EXO-AIDER/exo-aider/ADS8688_ADC_ARDUINO/README.md

# ADS8688a
ADS8688a Arduino Library

This code was strongly inspired by 
https://github.com/siteswapjuggler/ADS8688a
