EXO-AIDER/exo-aider/Todo/Hardware ændringer.docx

# Hardware ændringer

- Flyt FSR stik over på filter print (Husk rigtig rækkefølge)
- Fjern notch filter
- Tilføj connection ved modstand I LP filter
- Lav plads til stik (90 grader?). Kun stik i enderne af printet
- Lav plads/find ud af hvor ESPen skal monteres
- Nye filterværdier som set i simulering

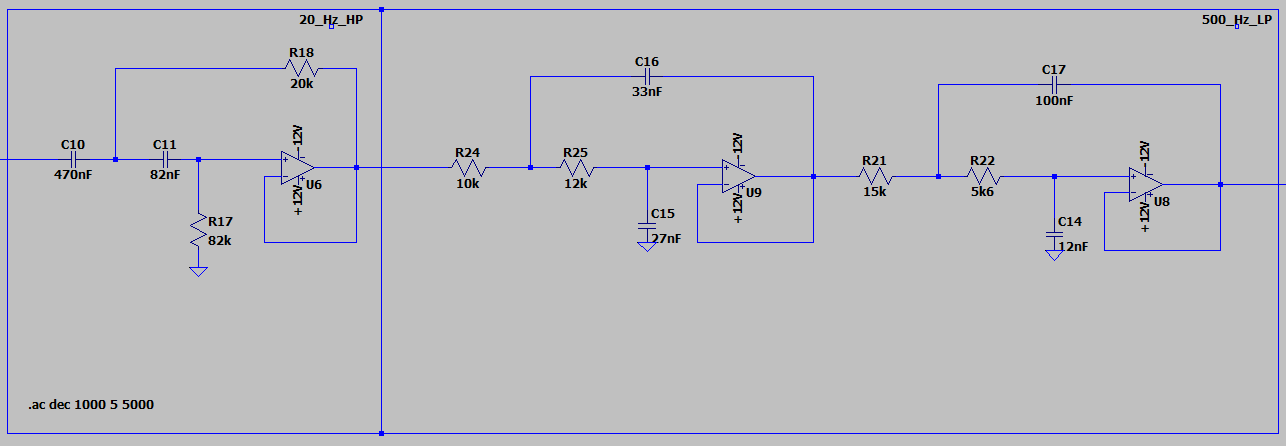
[picture p3: figure]
