EXO-AIDER/exo-aider/PCB/hardware_v2.pdf

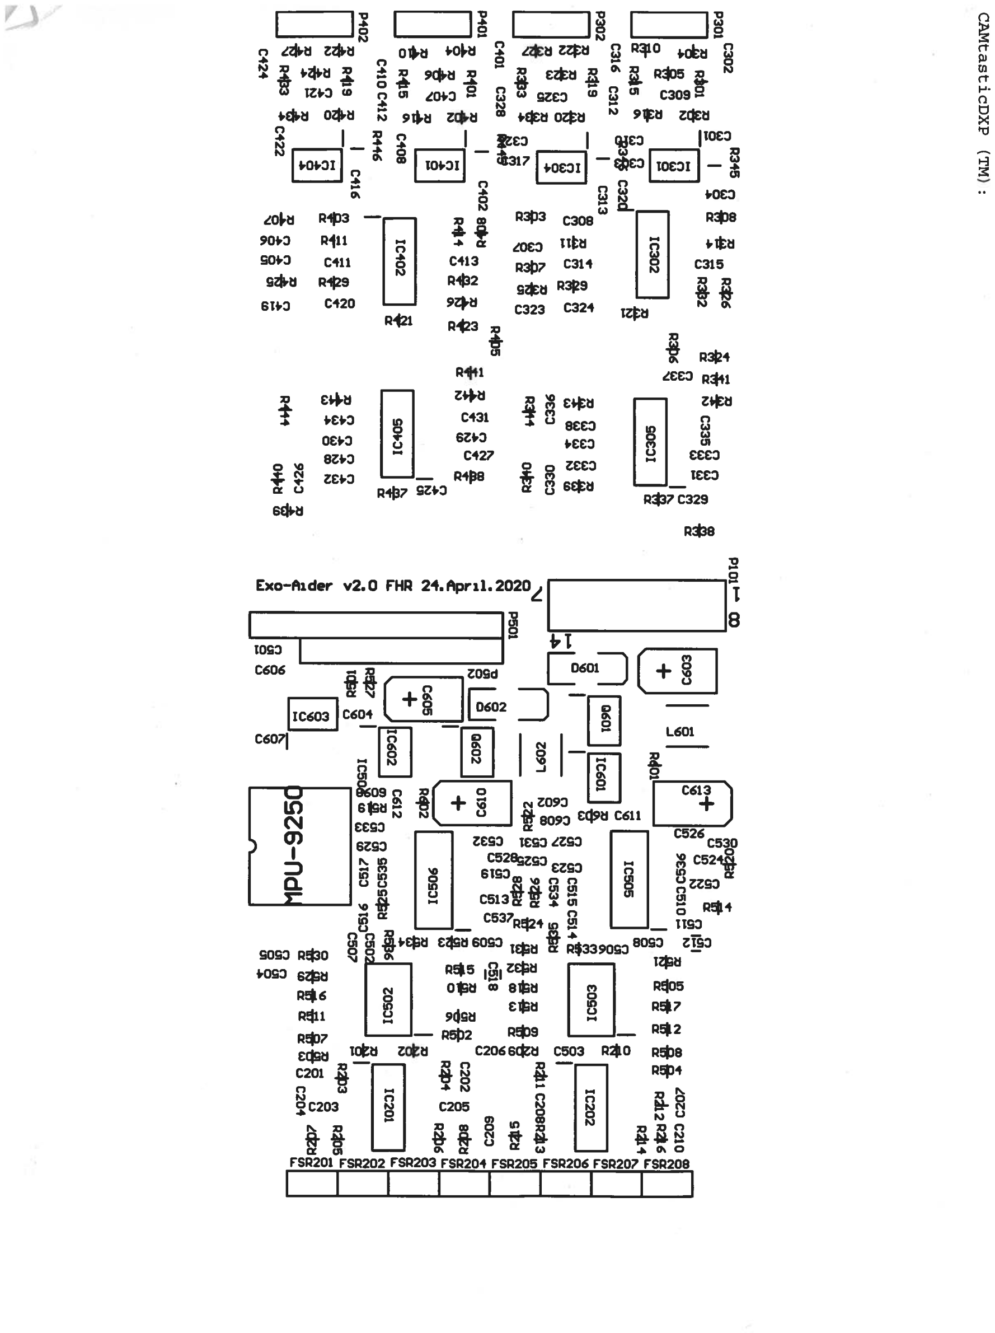
[picture p4: page 1]

### .iapt—ox Q7A tJH4

‘-I

8Ed

P1J39

### 4EttJ SZCO

### C331 P139 8E1*tI

4

D

### n ali-ti C425

t C432

O%C

### I I C333 C332 ° C428

### C33$ C*30 I-iil C429

C434 01 $

### Li *3fl LJ PS2 P142

r

### C337 14tI 1444-ti

## a *4cti to

n

### a c$ti 14? P121 CCCO 4-ZC3 0t*3 P426 C419 C4 ‘0

### 6dCd ftff P1135 6$tI [1 Øti I I aa C405 114-3 i 0 I,D i-ico I I 91C3

I p314 ° P311 I C307 C406 iti-ti mi Li t.
—

# ø P107 cdê-ti

N

1 (‘1 C304

# I 1C404 I I — Iii I304Ieicg IC301c3_ I ____ ____ ____ iN I

### —l caoil C3R3 C32Z I 0

P1134 P1120

### £ P116 P4J2 P3134 P120 Pt6 P3132 (‘4

### øC421 tOt C407 C325cnn 560E3

### P4134 WP436 P$3

N

### P404 P1137 Pl22 P110 P104 P3137 P122

# 0 oifrti

### 51 i oi i St

# Ii i ni nj______ ______

a I al

# a ______ ______

# I I I

# [1 1091 ___

# I Lo

## LIL

14

Bl

# 7otOrttcIwi. I 1.1

9093

C501 I

1’

fltle | EXO-AJDER
Size | Number | Revision
A4 | Blokdiagram | V2.O
Date: | 30-06-2020 | Sheet of I - | 6
LEie: | Z:\Frank\. .\Blokdiagram.SchDoc | Drawn By: Frank Høgh Rasmussen

## DAC_ADCJMU.SchDoc DAC_ADCJMU

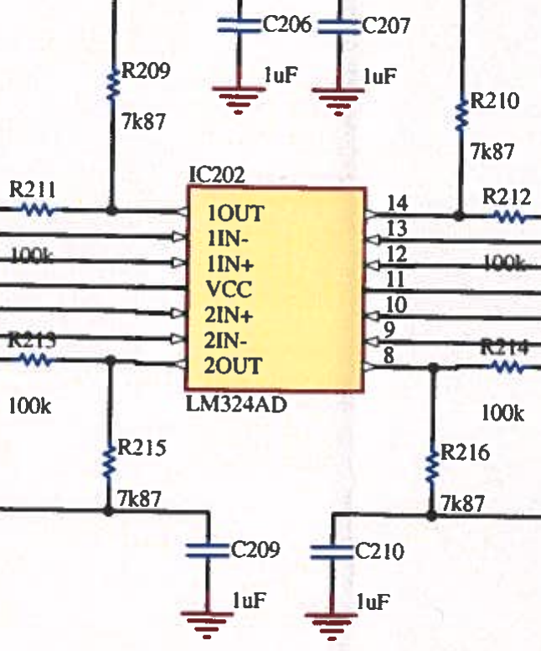
[picture p5: figure]

II,

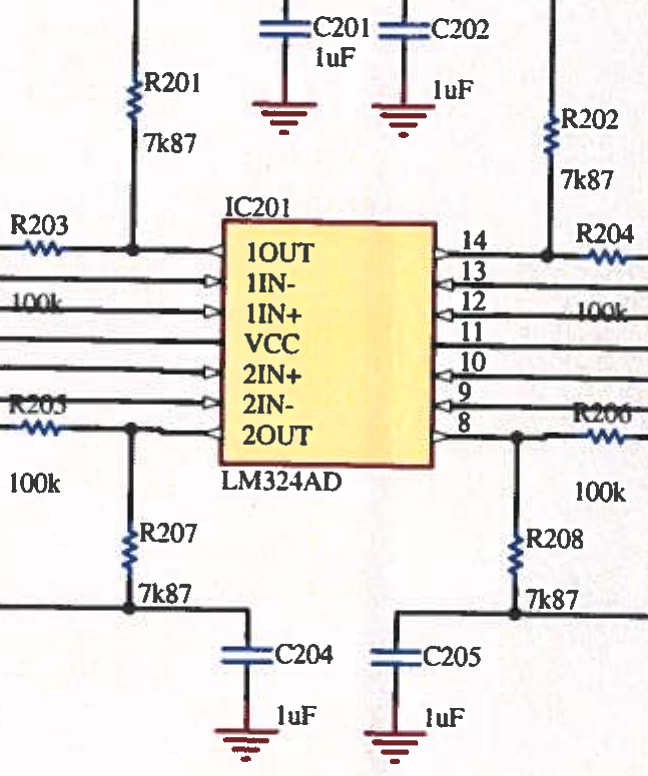
[picture p6: figure]

# SEMG

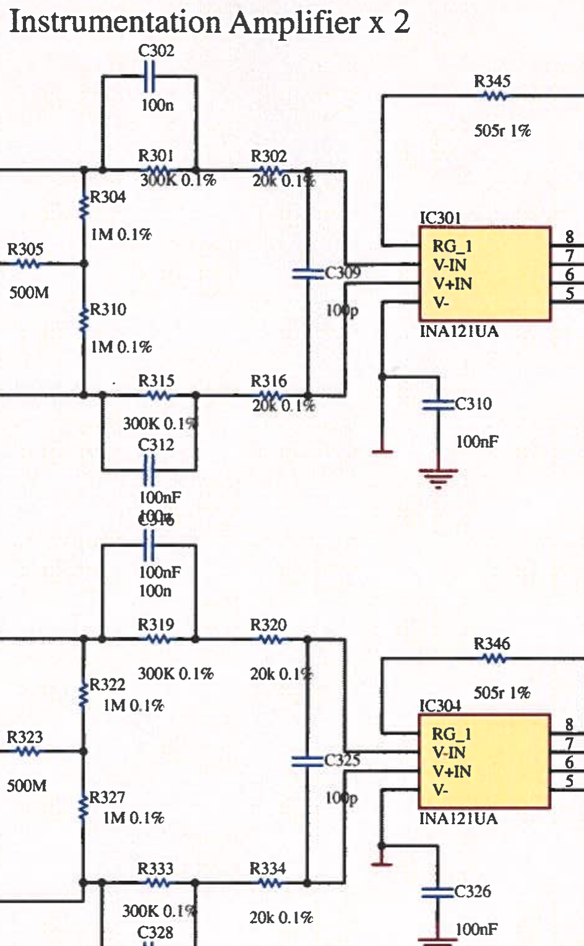
[picture p7: figure]

# High Pass Filter - 20Hz 2.th x 2

20k

C323 | C324
-HI

470nF S2nF
R329
82k

# ADJ-Buffer x 2

# Low Pass filter- 500Hz - 4th. x 2

# Tstle EXO-AJDER

Size | Number | | | Revision
A3 | SEMG 2 | V2.O
Date: | 30-06-2020 | — | Sheet of | 4- 6
File: | Z:\Frank\..\SEMG 2.SchDoc | Drawn By: Frank Høeli Rasmussen

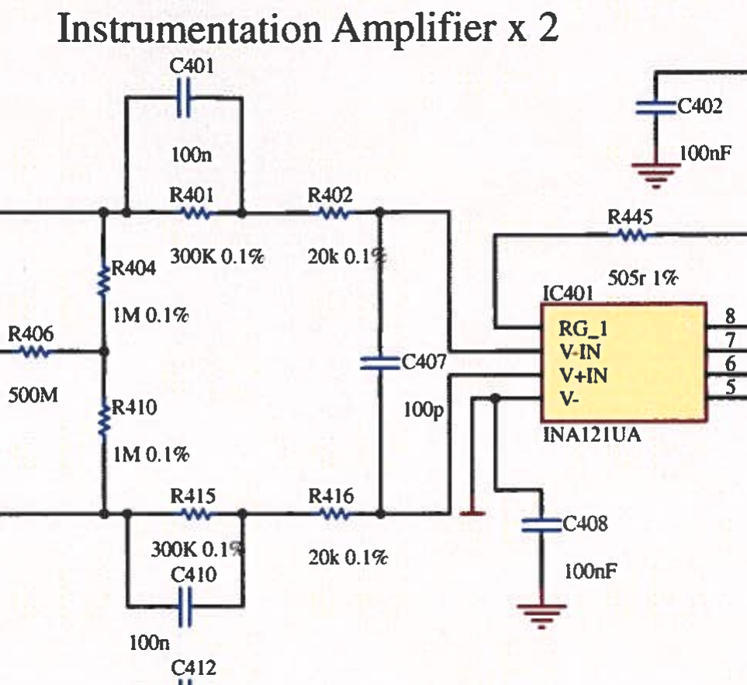
[picture p8: figure]

Instrumentation Amplifier x 2 | High Pass Filter - | 20Hz 2.th x 2 | ADJ-Buffer x 2 | SEMG

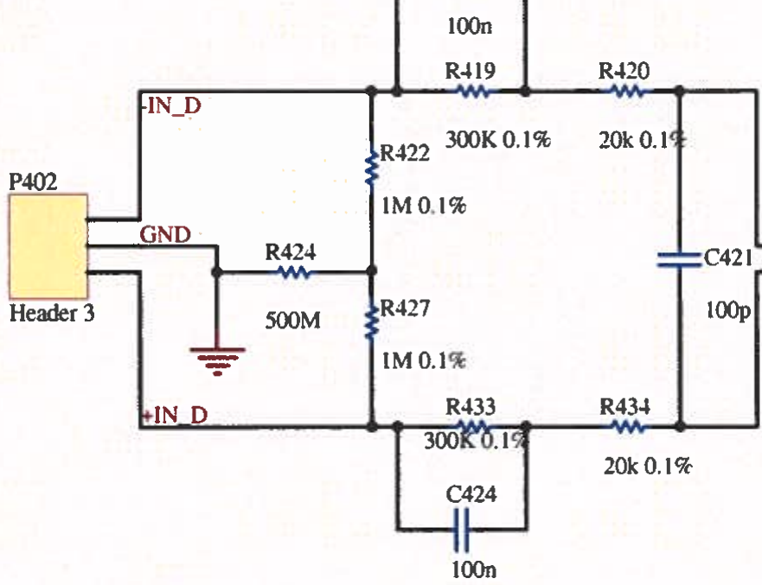
[picture p9: figure]

Low Pass filter- 500Hz - | 4th. x 2
lok | 12k
15k
lOk | 12k

I.

R502

lOK
El

DAC_2

1C503
AGND
FBA
OUTA
OUTB
FBB
REFAB
CL
Cs
DIN
SCLK
MAX525BCAP+

2
3
4
5 OND | 16
FSYNC OND | H
±i
| 8 Header 8

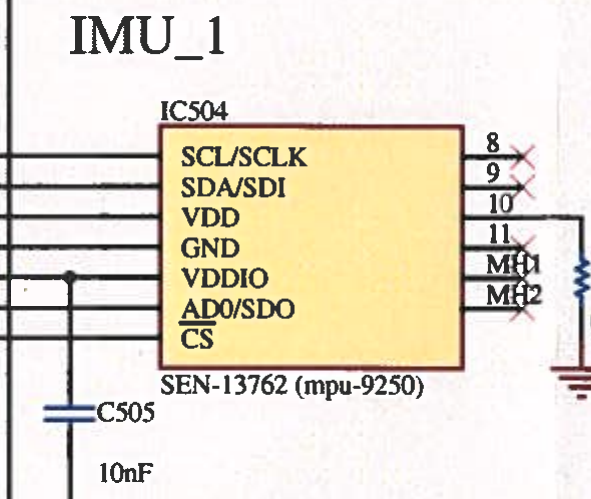
[picture p10: figure]
SCL/SCLK SDA/SDI VDD OND VDDIO ADO/SDO; SEN-I 3762 (rnpu-9250); IMU_1

P501
SDI
SDO
SCK
CSADC

T

CSDAC
CS IMU_2 6 CS IMU I

8
9
-E
- Header 10
L | I | I | I

Tie AGND and DCIND togethee at the DAC, then tie this point to the highest-quality ground available.

## I ——co

C507

DAC_1 | I | 147uF

# _____

LOK
1C502
AOND

R507
FBA | | 5K
OUTA | 17 | - | - | LIN_

MAX525BCAP+

# I+5VD+3v1ELjK

‘C50t

•[.lOOnF

R527

lOK

IMU_2
SDI

R504

lOK

‘C503

‘C5

7u]

1lOOnF I’ R505

- 10K
1J | R509
19
18

_

17

CS DAC

SDI

S(K

16

— | R5l2 | ______ 10K

SDO

1100r

CS_IMU_2

R513

5K

R5 18

lOK

### I+3V3DC 14

13 | I+5v1
11 | I53ji R532 | JR530 10K

SDI

CS ADC | CS ABC
CS IMU I | CS IMU 1 sC8c

19

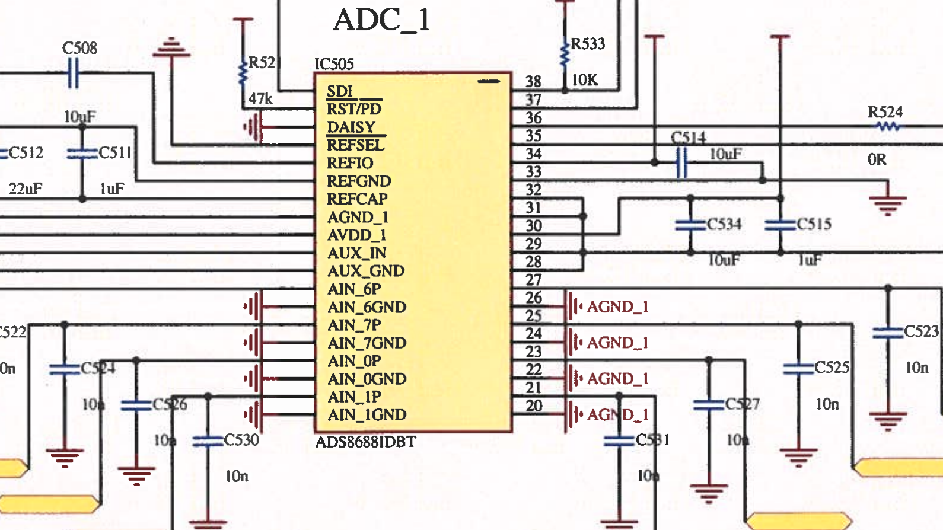
[picture p11: figure]
ADC_1; SDI RST/PD DAISY REFSEL REFIO REFGND REFCAP AGND_1 AVDD_1 AUX_IN AUX_OND AIN_6P AIN_6GND AIN_7P AIN_7GND AIN_OP AIN_OGND AIN_1P AIN_1GND; luF; toul; IOn; II iTtI1_I:
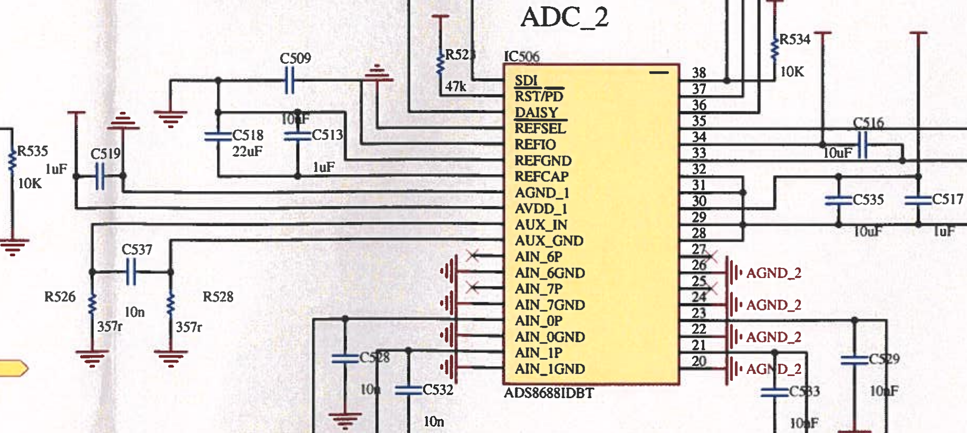
[picture p12: figure]
luF; lOK; ADC_2; j534 _1_J lOK; SDI RST/PD DAISY REFSEL REFIO REFGND REFCAP AGND_1 AVDD_1 AUX_IN AUX_OND AIN_6P AIN_6GND AIN_7P AIN_7OND MN_OP A1N_OGND AIN_1P MN_IOND; OuFII; AOND_2; AGND_2; lOuF; IOn; ]\lJ5O5TtiUb I; _j_ fII.A0_2

C5 10
*

luF

C536
II

SDO

(‘ IMIT ‘)

______________________

### ____________

_______ | ___________

SDI
SDO
SCK
CS_ADC
CS_DAC
CS_IMU_2
CS_IMIJ_I
i-3V3DC
VBAT
OND

____

AGND2 | R55 | OND

R536

lOK

AflND t | R522 | (IND
| Rest Or

1101F!

Res 1
Or | EXO-AIDER
Size | Number
A3 | DAC_ADC_IMU
te: | 30-06-2020 | - | - | - | Revision I Sheet ot
Z:\Frank’i..DAC_ADC_1MU.SchDoc | I Dr | By: Frank hRmussen

i

0

(i)

<

4: —

+0
rJ+

III,

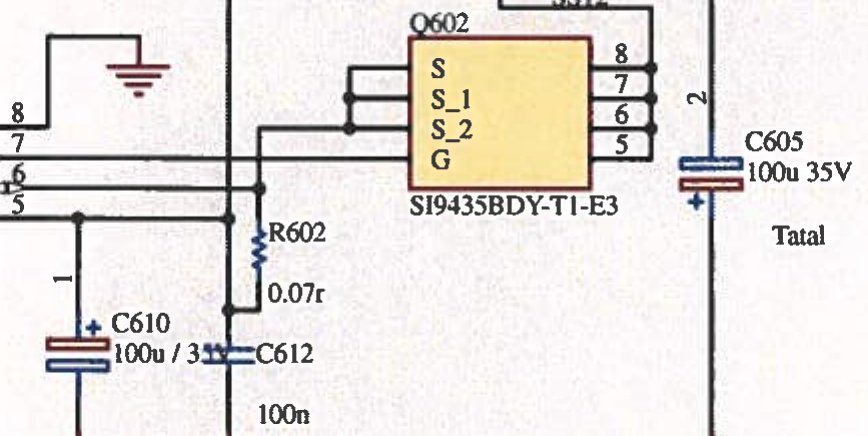
[picture p13: figure]
