EXO-AIDER/exo-aider/Pictures/hardware_block_diagram.pdf

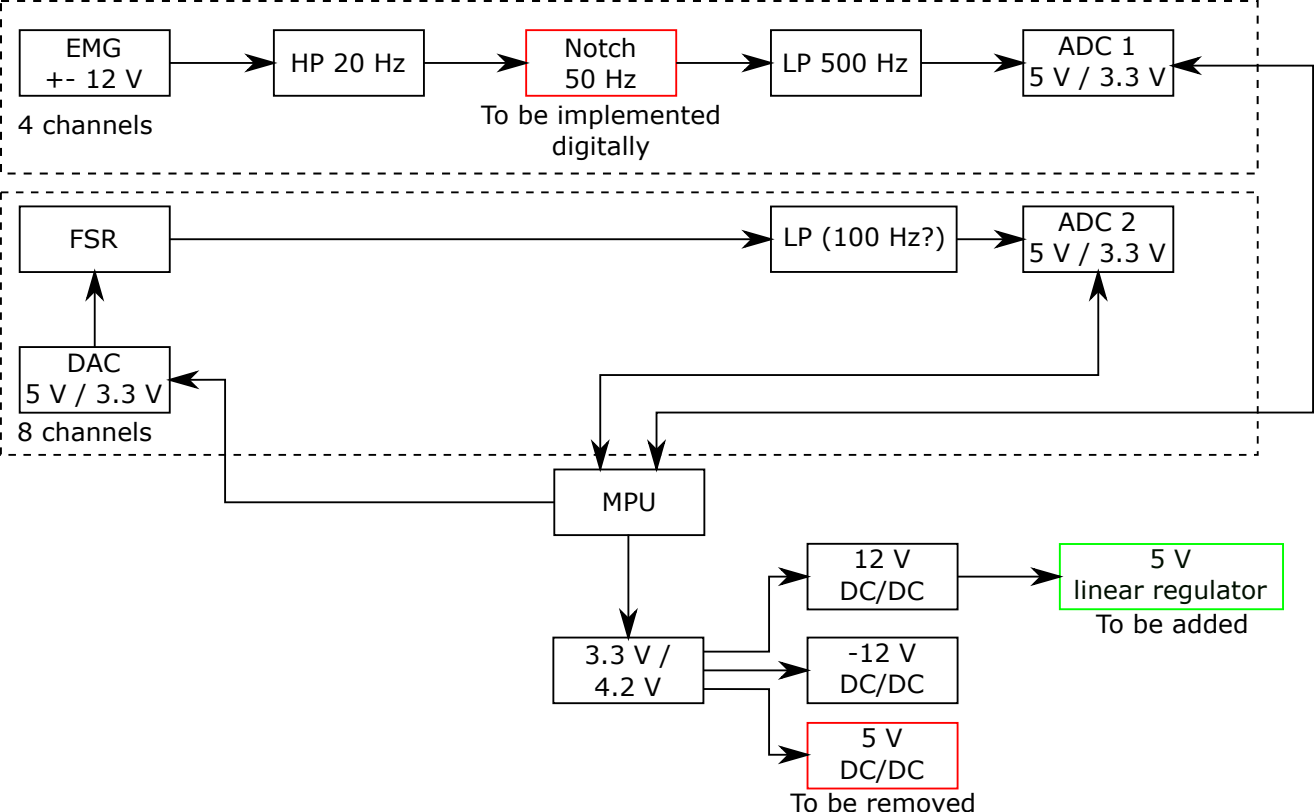
[picture p14: figure]
MPU; ADC 1; Notch; 50 Hz HP 20 Hz EMG +- 12 V; FSR; DAC 5 V / 3.3 V; ADC 2 5 V / 3.3 V; 4 channels; 8 channels; 5 V linear regulator; To be added; To be removed; To be implemented digitally
