EXO-AIDER/exo-aider/Pictures/matlab_block_diagram.pdf

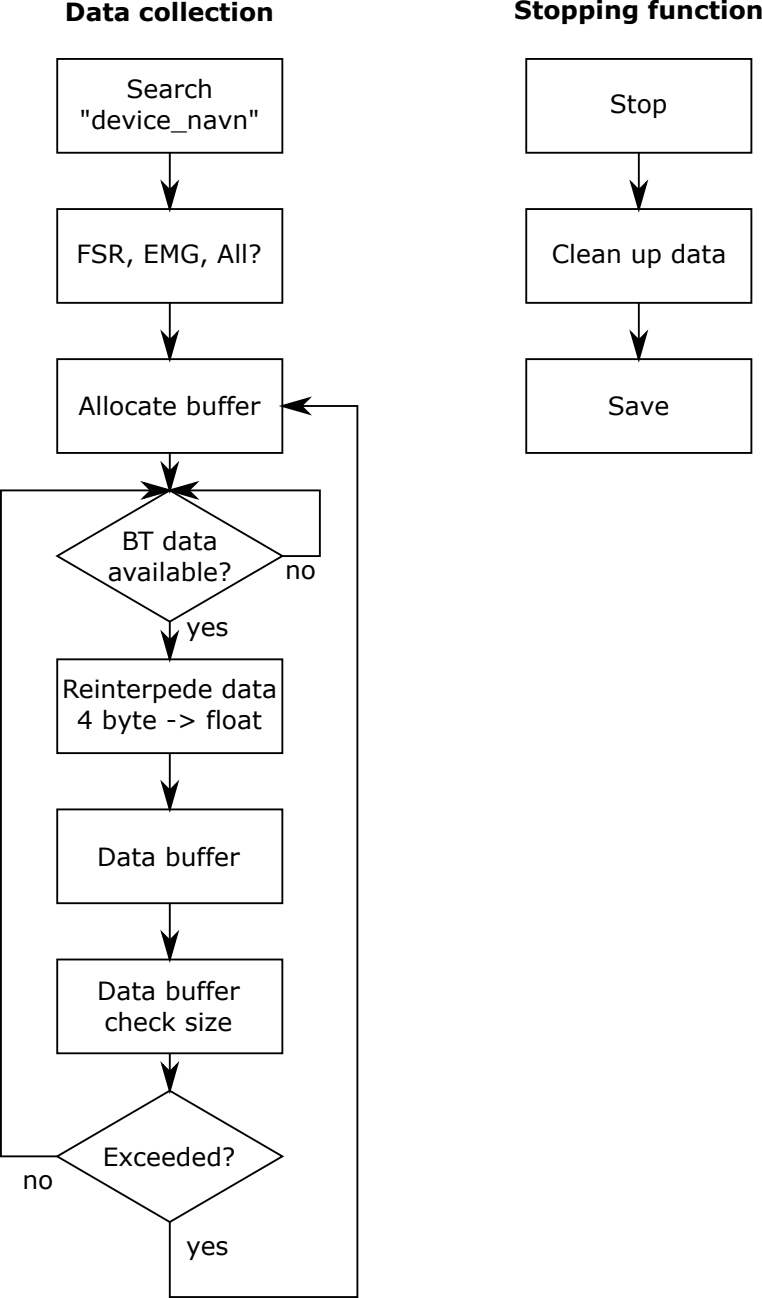
[picture p17: figure]
Reinterpede data 4 byte -> float; Search "device_navn"; Data buffer check size; FSR, EMG, All?; Allocate buffer; Data buffer; BT data available?; Exceeded?; yes; Stop; Clean up data; Save; Data collection; Stopping function
