EXO-AIDER/exo-aider/PCB/Scaned documentation/HW Version Zero.pdf

1 2 3 I 4

## SEMG_1 SEMG_I .SchI)oc

## SEMG SEMG2

## 2.SchI)oe

## DAC_ADC_IMU

## DACADC_IMU.SchDoc

## GND OND

## SEMGC <_

# SEMG_D (

## FSR.Sc

FSR

Doc

D
c
B

A

r

## FSR2JN

## FSR1J

K-Z

# FSR3jN (

## FSR4 IN

# FSR5_IN <-

## FSR7_IN

## FSR6JN

C

# FSR8_IN K_

# FSRLOUT <

## FSR3.OUT FSR2_OUT

<‘

## FSR4OUT <‘

# FSR5OUT <

# FSR6_OUT (

FSR7OUT <,

# FSR8_OUT <

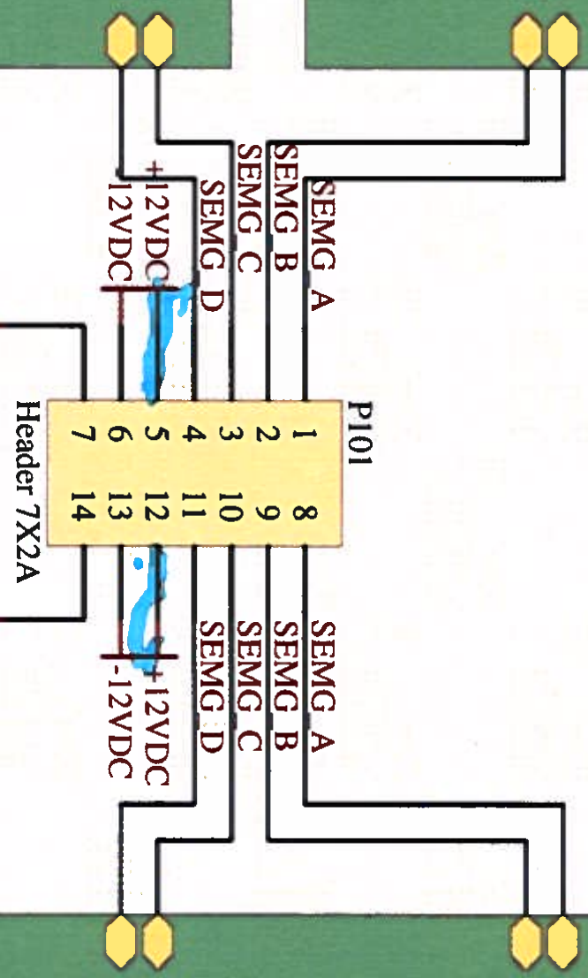
[picture p18: figure]
MGA; EMG B SEMO B; SEMG c 2 SEMG_C SEMG D 3 10 SEMG D

## •> SEMG_C

## > SEMG_1)

i’

## FSRI EN

## — FSR2 IN

## [SR3 EN FSR6JN

## FSR5_IN

## FSR4_IN

## - — FSR7_IN

•

FSR

## FSR8_IN

## t _OUT

## ISR4J)UT

## FSR3_OL

## [SR2_()UT

)

## FSR6_()UT FSR5J)UT

- ;

## [:SR8OUT

## FSR7_OUT

## U POWER

## ‘Doc

I

A

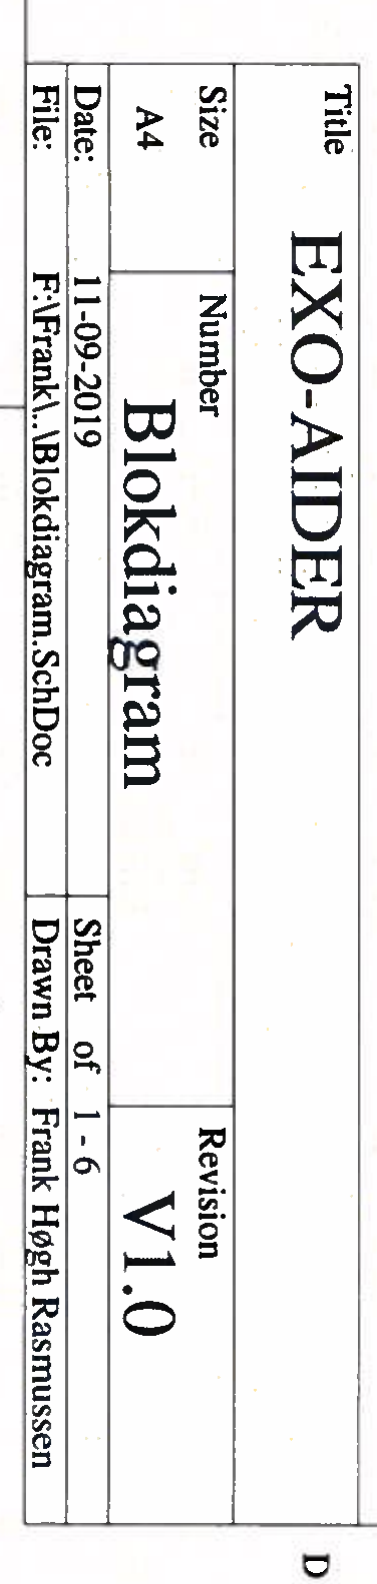
[picture p19: figure]
EXO-AIDER; Size Number Revision A4 Blokdiagram Vi .0; Date; 11-09-2019 Sheet of I - 6

## File: F:\Frank\. .\Blokdiagram.SchDoc Drawn By; Frank HØgh Rasmussen

2 I 3 4

# I I 2 3 I 4 5 6 7 I 8

2 3 4 5 6 7 /

i-i:

GND

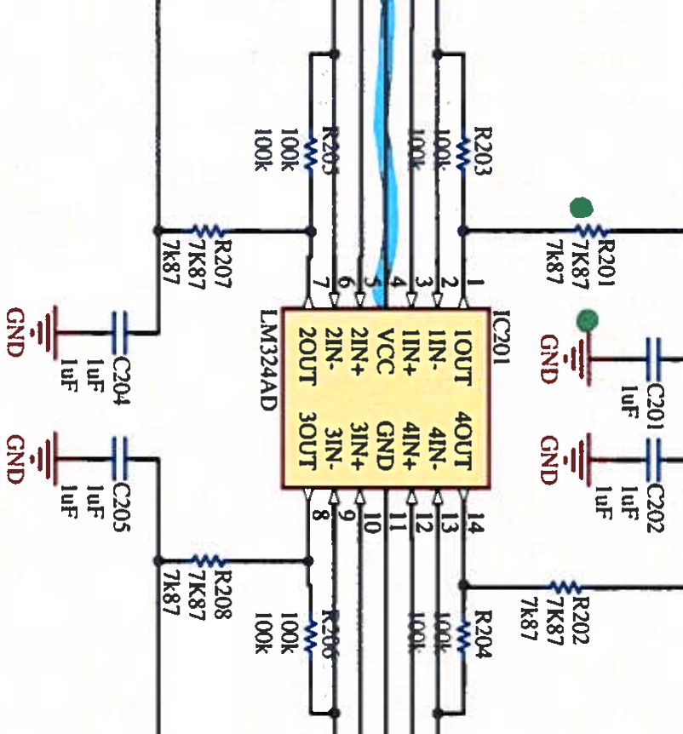
[picture p20: figure]
GND GND

GND

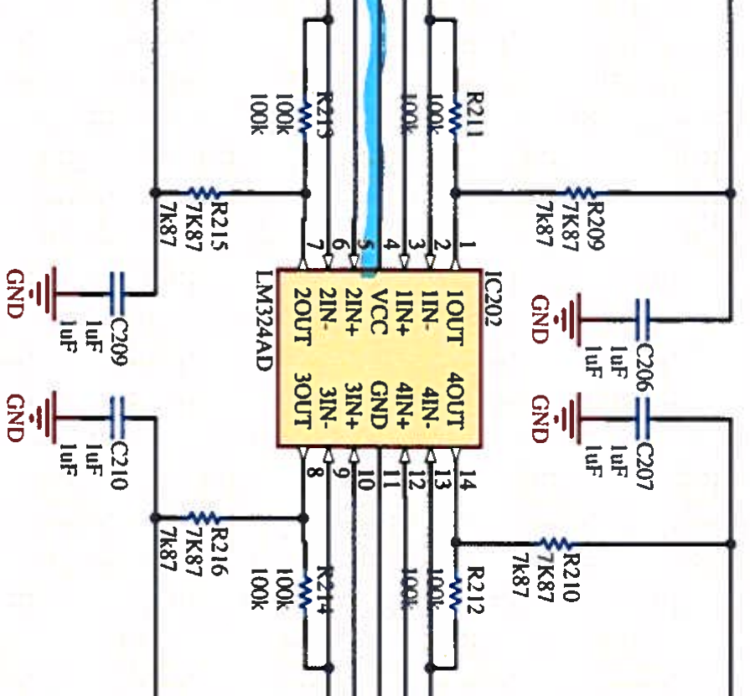
[picture p21: figure]
I j0 II uF luF luF; GND GND

l-SICStJS

# rtLJ

_[

Header2 -

GND

GM)

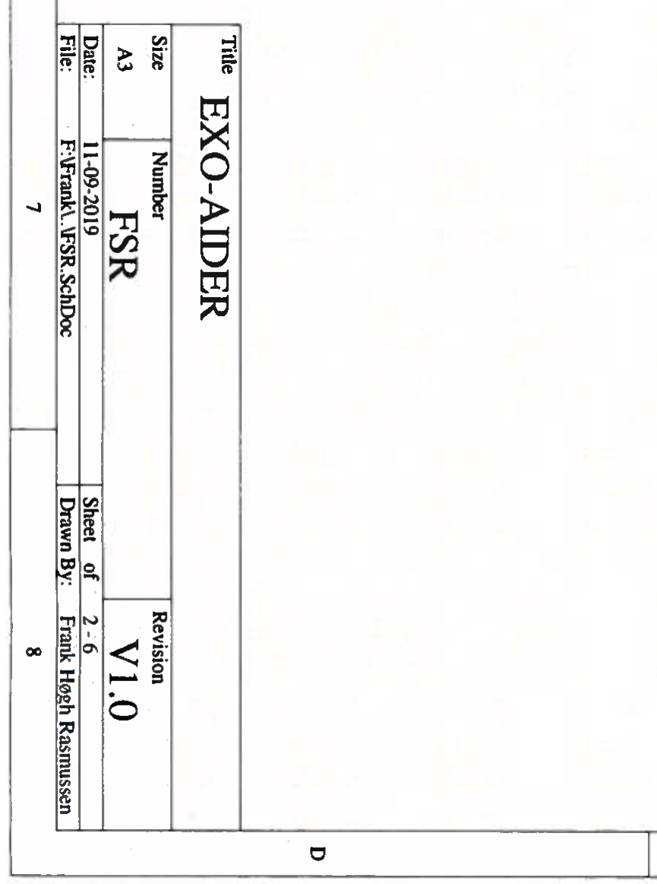
[picture p22: figure]
flue EXO-MDER; Size Number Revision A3 FSR V1.O; Date: 11-09-2019 Sheet of 2-6

File: F:FrankV.\FSR.SchDoc Drawn 8v: Fiank Hoeh Rasmussen

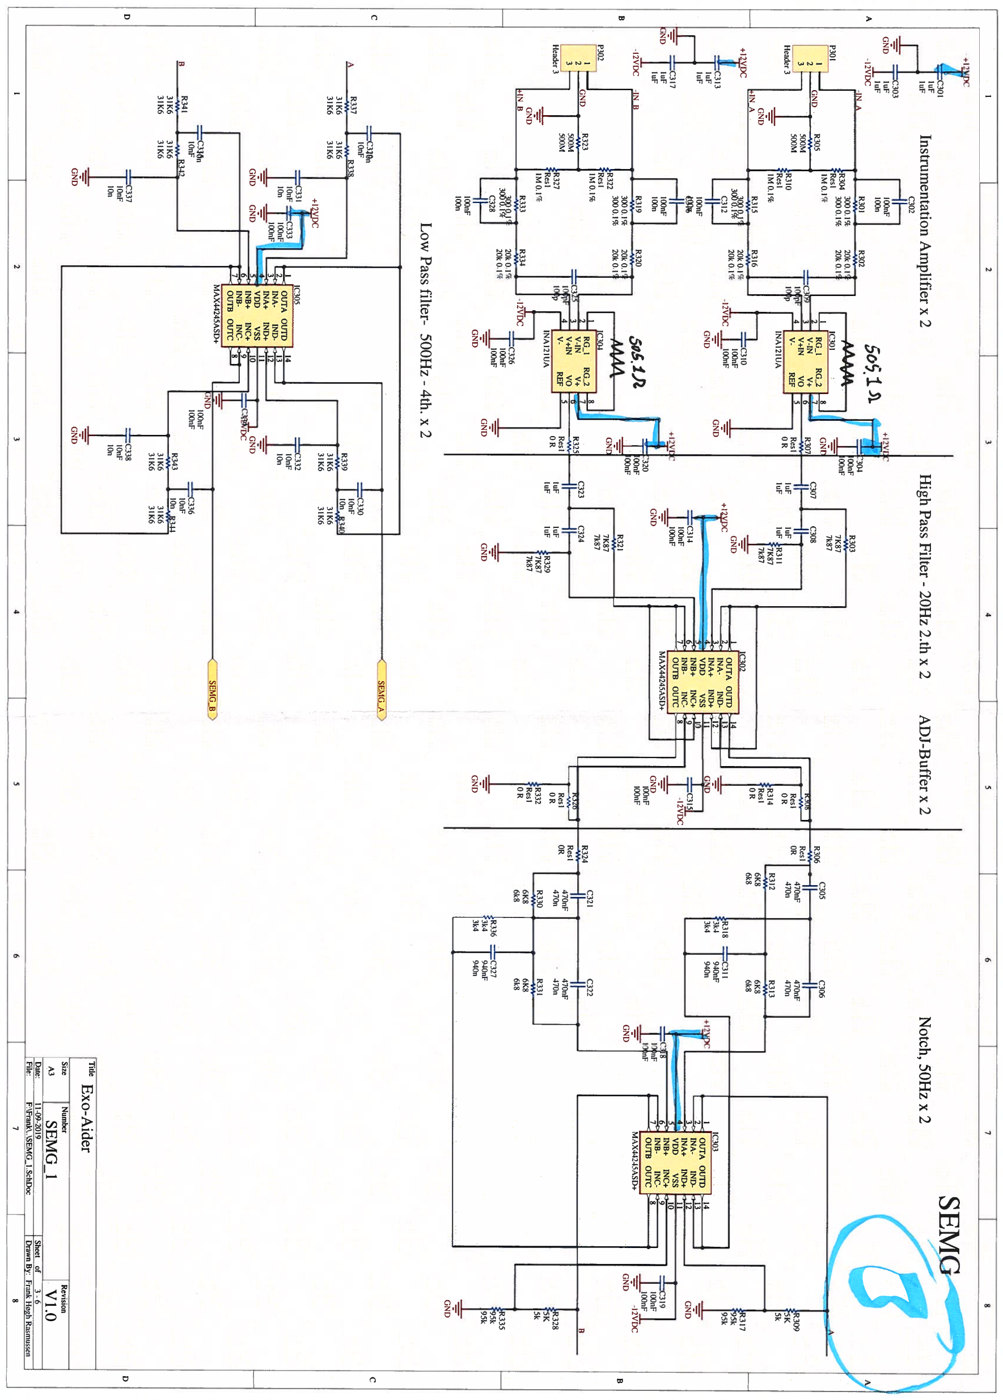
[picture p23: page 3]

I

+I2VDC

GN[3

c.o3

luF

luF

-I2VDC’

P30!
2 —3,

Hzader 3

## Instrumentation

C302

Res

R3I0

I

# IM 0.1% - R315 - R316

300 0. IÇ 3000.1%

C3 12

# Hft

IOOnF

# Hft

3000.1%
3000.1%

R319
lOOn

IOOisF

R327

Res I
IM 0.1%

R333 R334

## Low Pass filter- 500Hz - 4th. x 2

## ADJ-Buffer x 2

OR
Resi

R3 14

Res I

OR

## C305 C306 R306

## I 470nF OR

470n
C32t C322

ResI
R324

I II

470n

OR

R330

470nF

±C327

940nF

Jz

## Exo-Aider

Size Number Revision

# SEMG_1 I V1.0

Date: 11-09-2019 Sheel of 3-6

File: F5Frank\..\SEMG_1.SchDoc Drawn By: Frank Hoh Rasmussen

2 I 3 4 L 5

3000.1% R304 3000.1%
IM

Resi

0.1%

R305

20k 0.1

2OIs 0.1’

500M

500M

GND

I

fIN A

6

10

l0

I 7 8

## Notch, 50Hz x 2

L313

+12\’DC
I

I uF

I uF

=- C317
IND

luF

luF - 12V DC

Fleader

P302]

20k 0.1%

20k 0.1%

R320

## Amplifier x 2

+12V]

R302

i 51.

# I ic I

IPFN_RG2J_GM

INAI2ILA

OR

# —r 00sF

-I2VDC JJ00nF

GÇD —+ 12 VI

## 5g7LJZ

.14

1C30-4

GM

RcL2J

:

INAI2IUA

OR

-12 V DC

—‘—C326

I00isF

IO0nF

GND

-IN B

# SEMG 1

20k 0. I

20k 0. I

Res

R322

I

IM 0.1%

## High Pass Filter - 20Hz 2.th x 2

OOnF
304

R303
w.

7k87

OOnF

j

7K87

C307 C308

# II i i ItiF luF

7K87

# luF IuF3II I

7k87

## __________ — IC302

GND

# OUTA OUTD L14 I +I”VDC 2 INA- IND- L13 I

# ___

# 12 I i÷ IND+ III GD VDD VSS I 10

## 1-C314 INB÷ INC÷

## IOOnF i- INC

# J_IOOnF OUTB OUTC PH \IAX44245ASD+ GND

0OnF

0OnF
320

R32I

I

7k87

7K87

C323 C324

# -HI I luF 1sF

7k87

7K87

luF aF

G\D

R323

R3

470n

470nF

13

6kS

6K8

500M
500M

GND

I

-I5 R

6k8
6K8

C3

10
10

3k4

3k-I

R318 zC31 I

940n
940nF

±C3I5j

-I2VDC

GND
IOOnF

IOOnF

20k 0. 1%

20k 0.1%

3000.1

300 0. 1%

lOOn

IOOnF

C328

4
3:

5k

5K
R309

Ic

R3 17 _________________________________ 95k 95k
OUTA OUTD

INA- IND

## INA+ IND-i- i7

VDD VSS

# __t_C319 I

# INB- INC- 8 [I00nF I OUTB OUTC J_IOOnFj

MAX44245ASD+ -I2VDC

GN D GND

# I nF 7 nF

Res

“to

I

GND

3! K6
3! K6

R331
470n

470nF

6k8

6K8

31 K6

3IK6

6k8

6K8

B

3k4
3k4

R336

31 K6

31 K6

95k

95k

R335
5k
5K

R328

GND

31 K6

31 K6

31 K6

31 K6

1 2 3 4 I 5 6 7 8

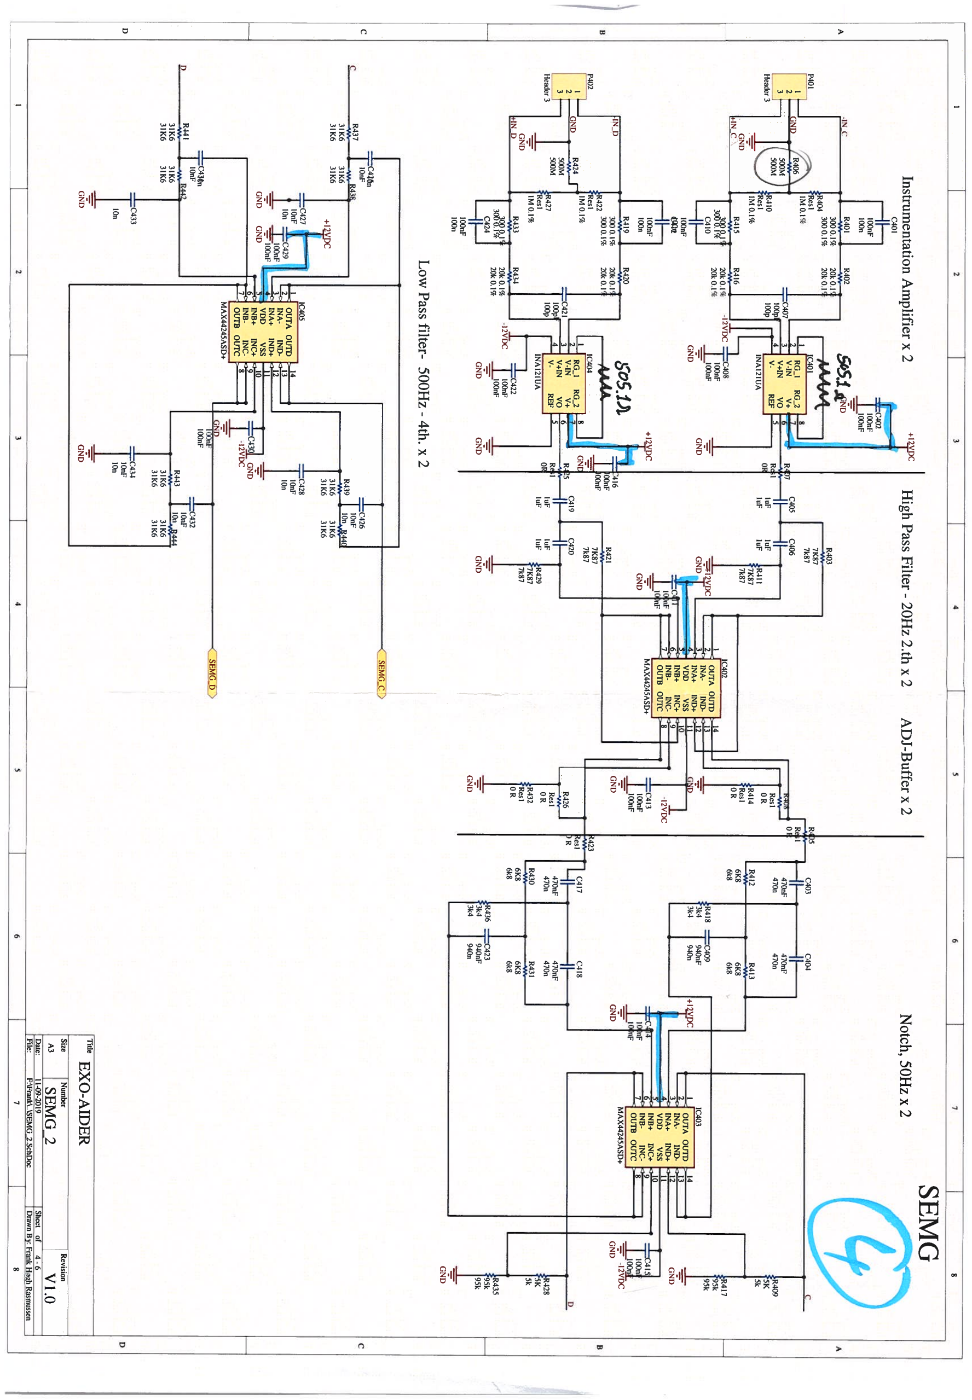
[picture p24: page 4]

I

## [is_i 3000.1%

P402 I

J.R4» 3000.1%

I --

I

ResI

2

IM 0.1%

500M R1

OND

IM 0,1%

## R433 IN D

lC403

_______

10

# OUTC I

MAX44245ASD÷ — -12’

GND

## i I 2 I 3

IN C

# Instrumentation Amplifier x 2

0l

, .

-C402

lOOnF lOOnF

lOOn lOOnF

# R401 R402 5c5j ND

L

Header

P401

3

# ..—.———w——-..—-—--——-w—.— I — 3000.1% 20k0.1{

R404 3000.1% 20k0.11

Res I

“

‘

IMO.I%

OND

500M

R406

]

500M

I3.i%

# 4N_C - R4I5 — 300 0.1 20k 0.1%

R4l9
lOOn

;i
lOOnF

R-I20

1C401
RG1 RG_2

C407

‘

R

INAI2IIJA

-I2VDC

iOOnF

lOOnF

C408

GND

GNO

8 6

# SEMG

# Notch,5OHzx2 IIIIIIFI%IIII%)

470n
470nF
C404

R413

# High Pass Filter -20Hz 2.th x 2 ADJ-Buffer x 2

R403

I

# 7K87 R 7k87

# II T ResI I OR luF luF R411

c405 C406

# 7K87 I R4l4

ResI

luF luF

}87

## OLTA 14

1C402

# I2V1)C INA- IND T IND+ I12 I

# I11 GND i— I ‘ VDD T i Q INII+ INC÷ — I 6 INB- INC i( nF OUTB O1JTC 8 — I -I2VDC

MAX44245ASD+ ‘C4l3

### OND TIOOnF

......LIOOnF

416 G\D

7k87
R421

I

7K87

C4I9 C420

# HI II

nF luF

7K87

R4’9 luF luF

GND

}87

6k8

6K8

20k 0.1

20k 0. I

R434

# C403 E}HH

470n

470nF

R$ 12

423

R4 18

3k4

3k4

+I2VDC

__
t1: 1C404

### V-IN + R

# L_JJ RG 2 8

## C421 _I v+IN VO

______

### R —j_ V- REF

# 1\A 121 CA :1- ±c4 Ol I\DC

# II00nF IOOnF

OND OND

=C409

940n

940nF

+12VDC Ï

lOOn

IOOnF

C424

6k8

6K8

# ‘j 9 C417 RHH

470n

470nF

R430

R4
5k
5K
R409

17

95k
95k

“DC

20k
20k0.1%
0. 1%

# Low Pass filter- 500Hz -4th. x 2

Res

R426

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
R436

zC423

940n

940nF

31 K6

31K6

95k

95k
R435
5k

5K

R428

GÇD

31K6 311(6

# EXO-ALDER

Size Number Revision

# A3 SEMG_2 Vi .0

Dale: 11-09-2019 Sheet of 4 - 6

File: F:Frank\..’SEMG_2.SchDoc . Drawn By: Frank Hogh Rasmussen

2 4 5 6 7 8

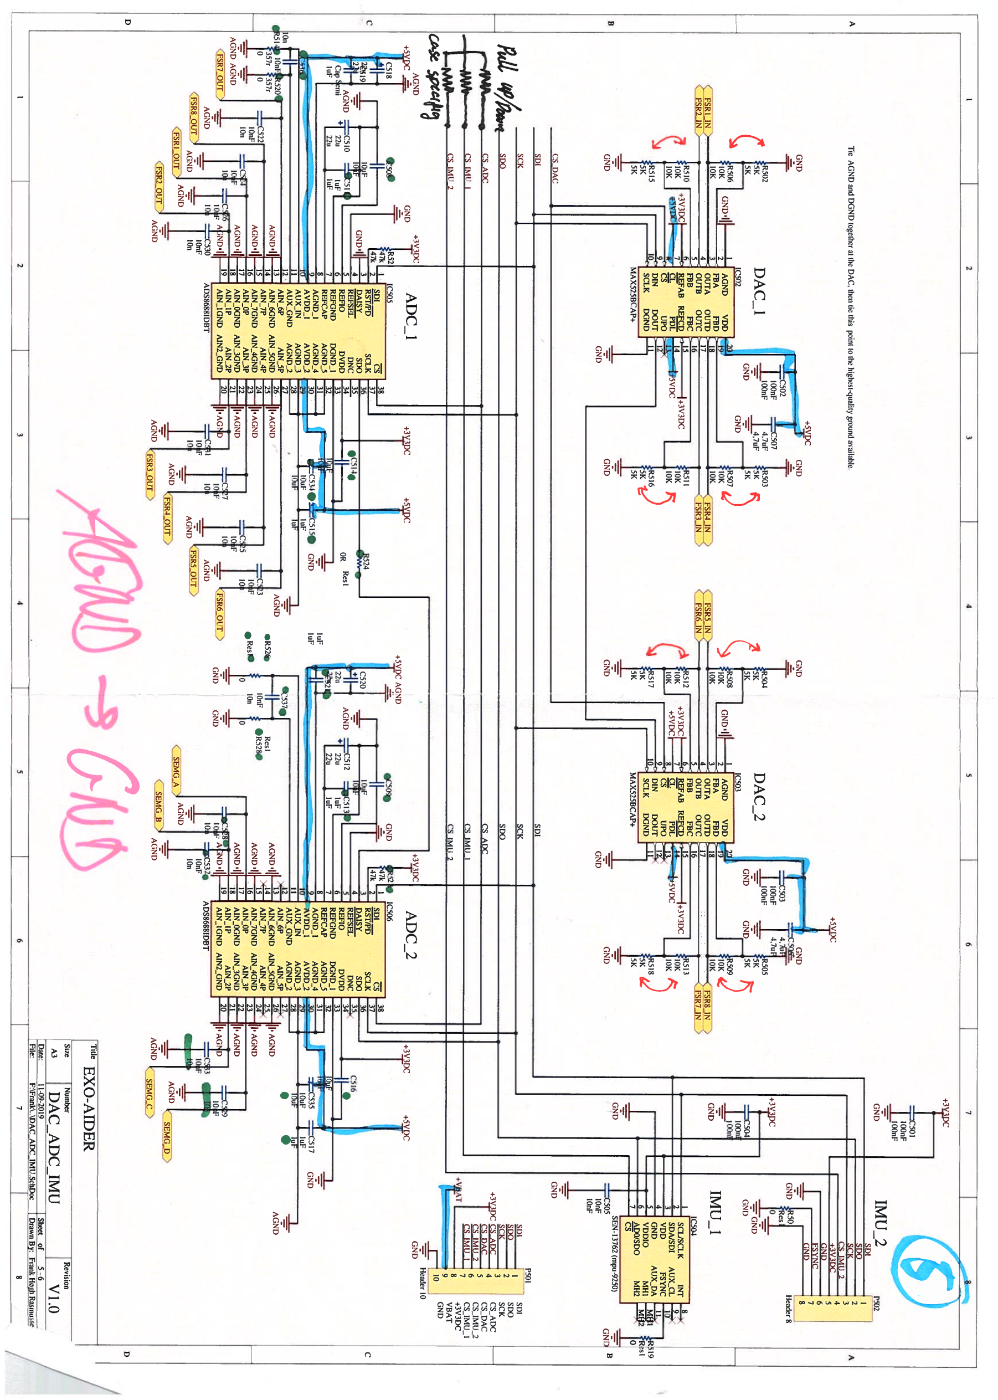
[picture p25: page 5]

### I I 2 3 I 4 I 5 6 7

+5VDC

IOOnF C507

### DAC_1

IOOnF

G\D

GND

19

20

$÷3v3Dc

### I+5VDC

GND

i

### ADC_1

1C505

cs

SCLK
DNC
SDO

AIN_IGND
AIN_IP

AIN_OGND
AIN_0P

AIN_7GND

AIN_7P

AIN_6GND
AIN_6P

AUX_GND
AUXJN
AVDD_1

AGND_1

REFCAP

REFGND

REFIO

REFSEL
DAISY

RST/PD
SDI

ADSS688IDBT

lOK

R507

5K
5K
R503

FSR3JN

R51 I

5K

5K
R516
10K

lOK

G\D

1(503

### DAC_2

AGND VDD

FBA FBD
OUTA OUTD

OUTB OUTC

FBB FBC

REFAB REFCD

PDL

Cs Upo
DIN DOUT

SCLK DGND

NIAX525BCAP+ 5K

5K
R518
lOK

lOK

R513

GND

+3V3DC
I‘C50l lOOnF IOOnF
GND

I

+3V3DC

IOOi

lOOn

GD

IOnF
lOuF

C505

P501

SDI

## 2 SCK

+3V3DC CS ADC
T

(‘S

(‘SDAC
IMt 2

C’SIMtl

Header tO

G\D

Tie AGND aird DGND together at the DAC. then tie Ihis point to the highest-quality ground availahie.
T502
GND

# O6 GND ‘ii

lOK

GND

1(502
SCLK
DIN

CS
CL

REFAB

FBB
OIJTB

OUTA
FBA

AGND

FBD

VDD

OUTC

OUTD
FBC

REFCD

Upo
PDL

DGND
DOUT

GND

lOK

lOK

5K

5K

hIAX525BCAP+

G5D — CS_DAC

## I ..-.___.-___

+5V DC

(‘503 4,7ii
IOOnF d,7u
lOOnF

5K

R505

GND GD 5K

r

lOK

# R509 -—8JN

CS
srtn

SCK

ADC

EB

## R.512 +3v3DC1

lOK

VDC8

R5l7

5K
5K

GNO

CÇ I\{Tr

# IMU_2 ri P502

CSIMU2

GD R501 Header8
fi

UND

UND

### IMU_1

1(504

# i1j S/SDI AUXCL

OND AUX_DA

MH2

SEN-t3762 (mpu-9250t

ONE

# I+3”3 :4*svDc

i-GND

C’S l\11 2

C

GAD

I

### Ct’ÇL

AGND +3V3DC

÷5VDC GND
•50 R52 C5 18

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
+3V3DC +5VDC
I

GAD

C T?sÆtT i

CS IMU 2

+5)C AGND

# C514• --—-— i OK ResI

L11T.
32

(

DVDD

AGND_2
AGND_3

AVDD_2

AGND_4

AGND_5

DGND_I
AIN_SP

AIN_5GND
AIN_4P

AIN_4GND
AIN_3P

AIN_3GND
AIN_2P

AIN2_GND

## FSR2_OUT AGND

# ADC_2

### cso GND 52 1C506

747k i

L512

I.

# IF—147kT

AGND

T22u

luP

22u luF 7

22u
C520

I uF
luF

+3
CSJMU_1

CS_IMU_2

CS_DAC

CS_ADC
SCK
SDO

SDI
V3 DC

GND

VBAT

8

•R524

.Res

+3V3DC +5VDC

36

37

C516

3’ I

__

AG.ND

# ____

# ! 4__ t 7 FSR6

FSR5 0111’>

## AGNO 4 OUT

AGND

•C537

ResI

### tOnF •R528•

tOn

O 0

GND UND

SDI (5

RST/PD SCLK

DAISY SDO

REFSEL DNC

REFIO DVDD
REFGND DGND_1

REFCAP AGND_5
AGND_1 AGND_4

AVDD_1 AVDD_2
AUX_IN AGND_3

AUX_GND AGND_2

AIN_6P AIN_5P

AIN_6GND AIN_5GND

AIN_7P AIN_4P

AIN_7GND AIN_4GND

AIN_OP AIN_3P
AIN_OGND AIN_3GND

AIN_IP AIN_2P
AIN_IGND AIN2_GND

32 Ii) II-

31 I 1#

## 30 .i-.-1.I C535 — C5l7

## 29 1 I lOuF T’luF

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
AGND

AGND

ii

AGND II

AGND

# AG\D __ K

ADS85881D13 I

## -i- tUut- lut- 28 I

# AG’D t’ I1G

JIAGND
Ii.

—‘—C 9

### --llI.AG}

AG\D

ACD

SEMG_>

2 I 3 I 4 5 6

I File:

# Title EXO-MDER

Size Number Revision

# A3 DAC_ADC_IMU V1.O

## Date: 11-09-2019 I Sheet of 5 - 6

# P-sP,,,L-\ sriuc urir’ mAlt e.hrs,, Frank Hugh Rasmuss / Drawn By: I 7 I

+ {

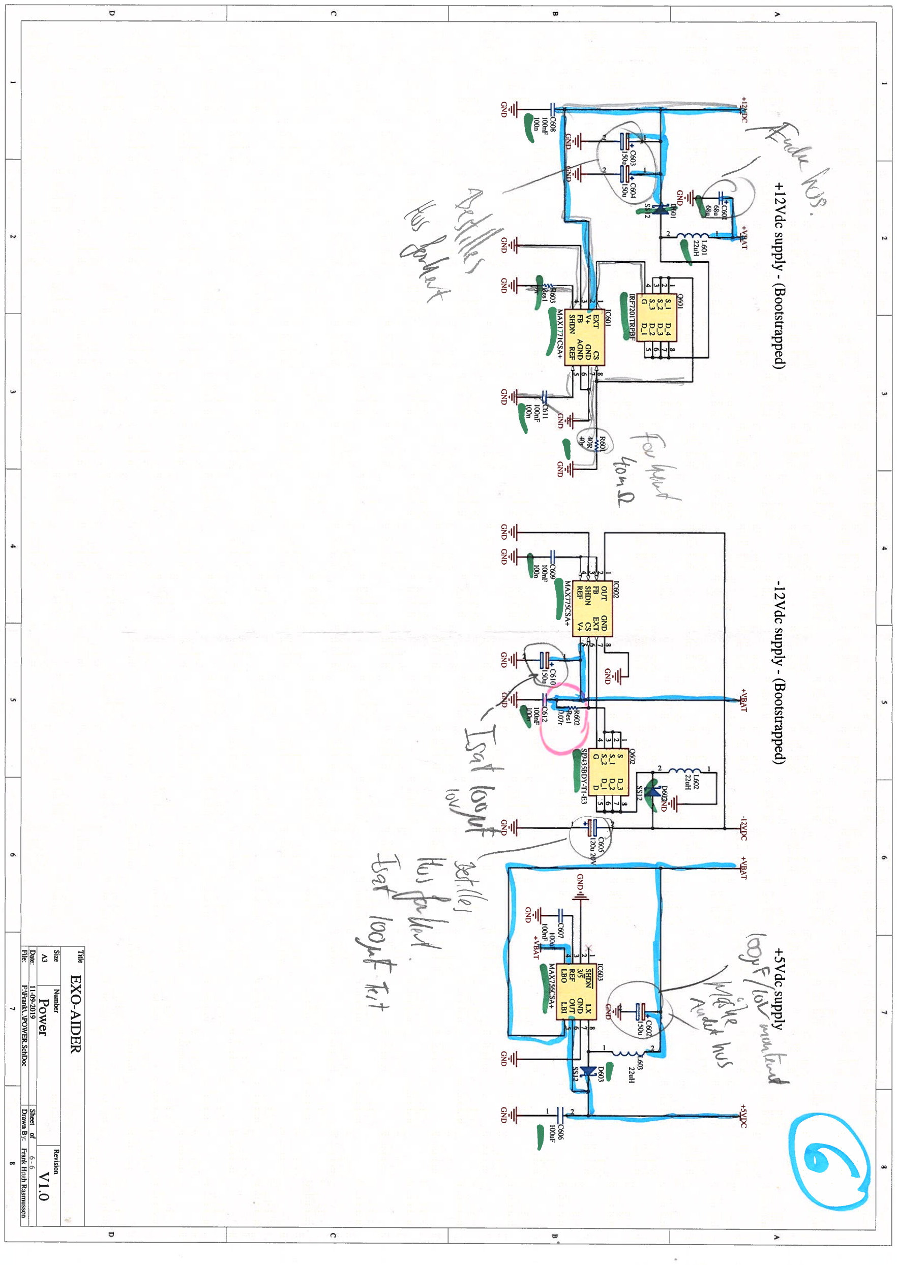
[picture p26: page 6]

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
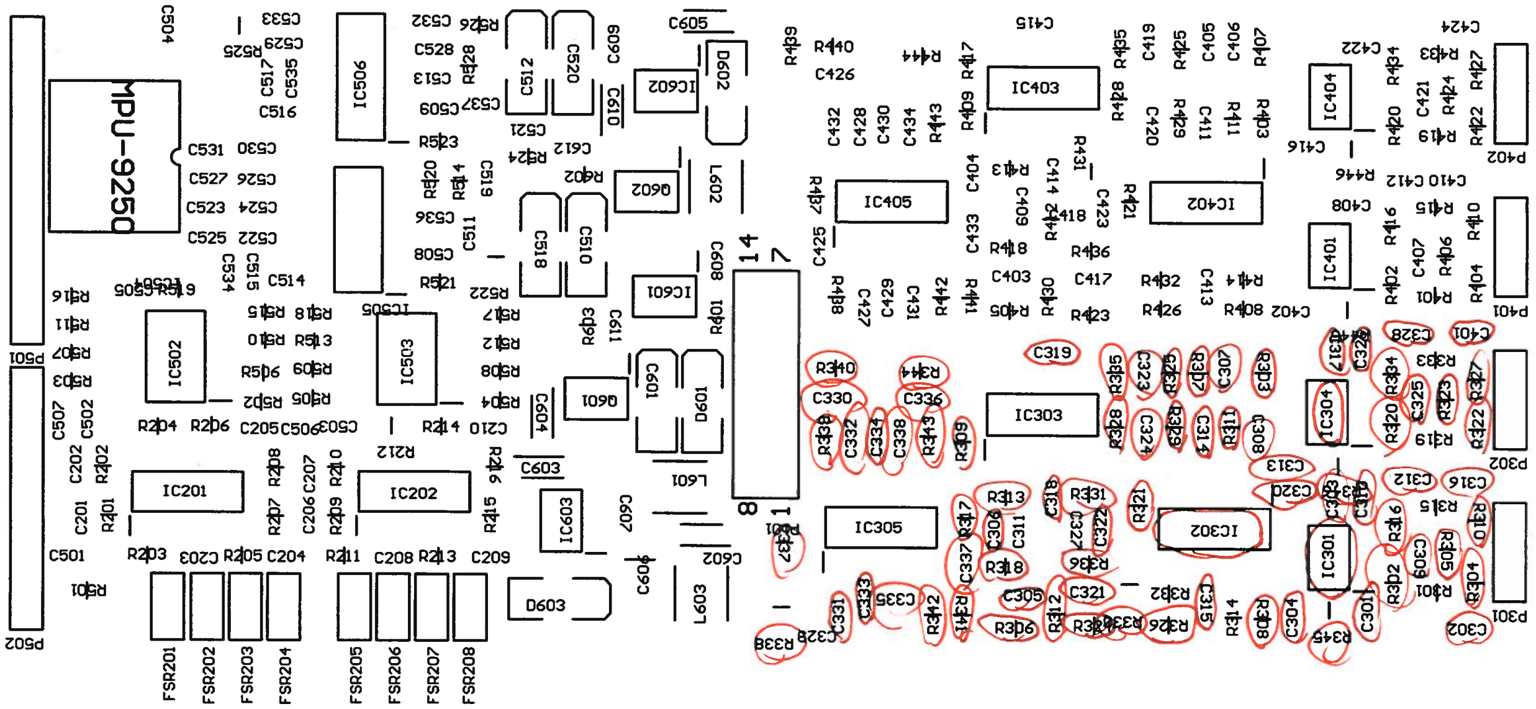
[picture p27: figure]
g6—fldJ; FSP2O1I____ () FsP202I I(’; I FsP2O3I c-:i; 0 øl ____ (31 FsP204I i r%) (-) 1° øl ‘; FSR2O5 I; FSP2O6; FSP2O7; FSR2O8I I ri; orfl __; Eos3Z; Ifl; — jIc4oi

0

x
0
(i)
CO

ci
