EXO-AIDER/exo-aider/PCB/Scaned documentation/Original Block HW Block Diagram.pdf

:zz

—I4AMA’ | fr’ | ———-—————— | — — | — | —I | — | — | — HHEE — | — | - :: | ———————- | “‘

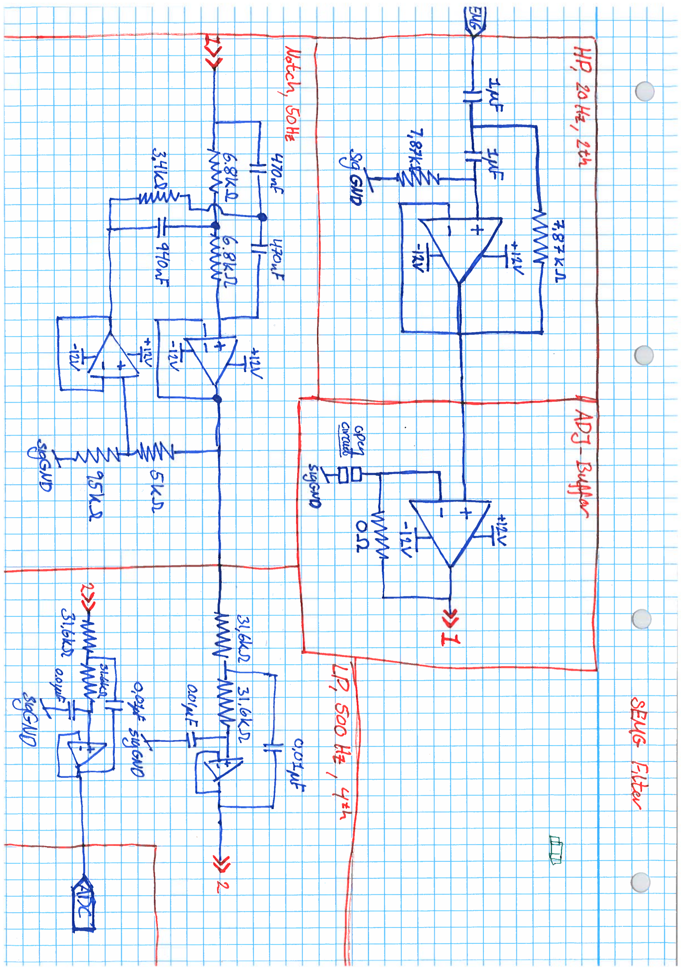
[picture p28: page 1]

— | —---—I—————— | —— —— | — | -----————— | —————-————— -— | - | ---------- EEZ | :zzzzz j:z::

# z 1içI

c.’

t

.- | 1+
0 | L — | -- ‘
- j4

•%
c

‘

*

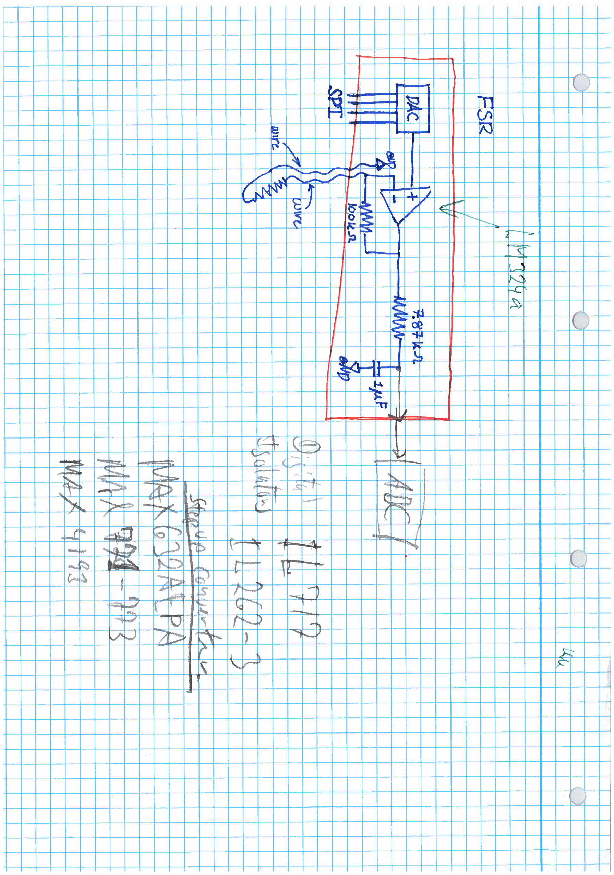
[picture p29: page 2]
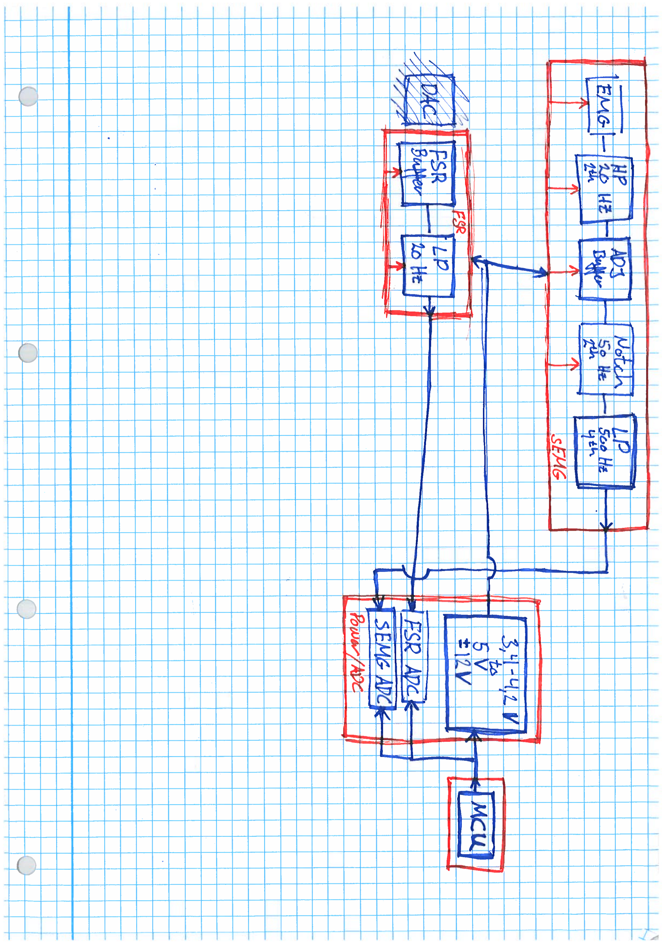
[picture p30: page 3]
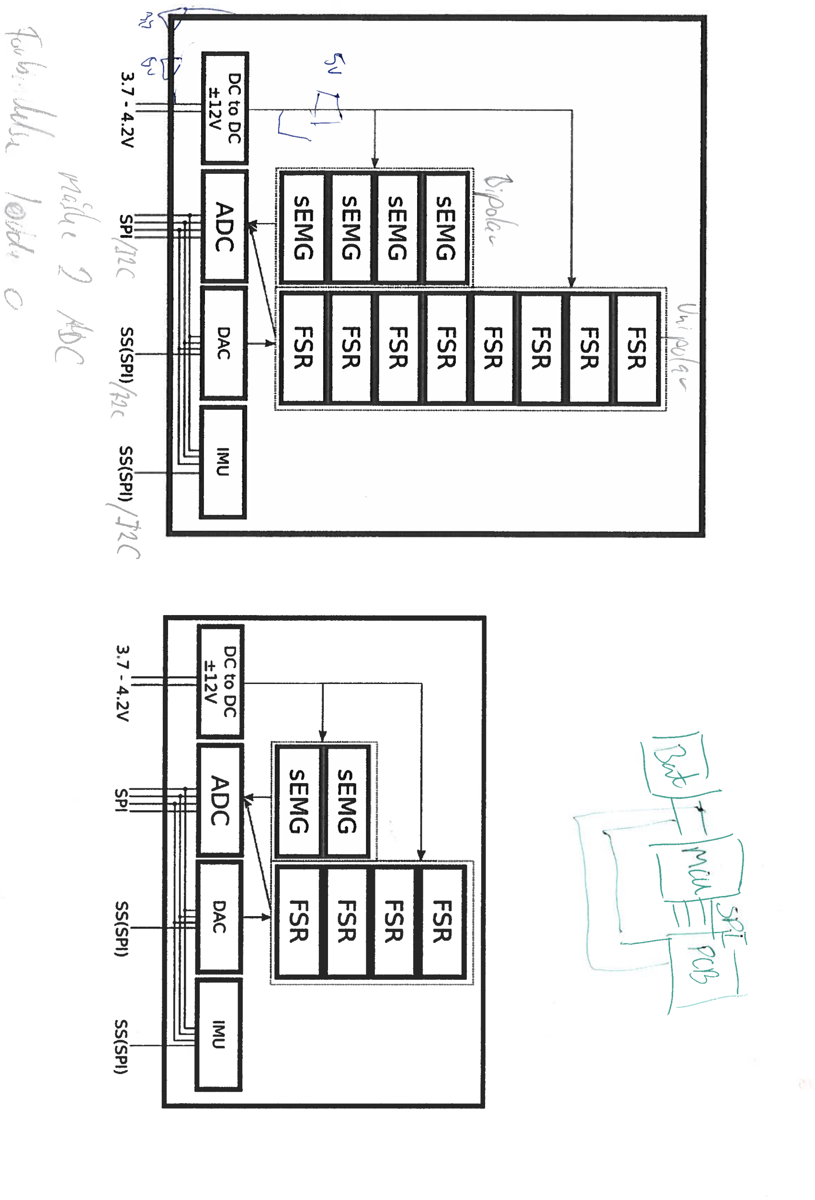
[picture p31: page 4]

# FSR

# . FSR

# sEMG FSR

# sEMG FSR

# I DCtoDC

II

2 /4(

J/

II

II

C 37

# -4.2V SF’I SS(SPI) SS(SPI)

‘—I
