EXO-AIDER/exo-aider/PCB/Scaned documentation/Random2.pdf

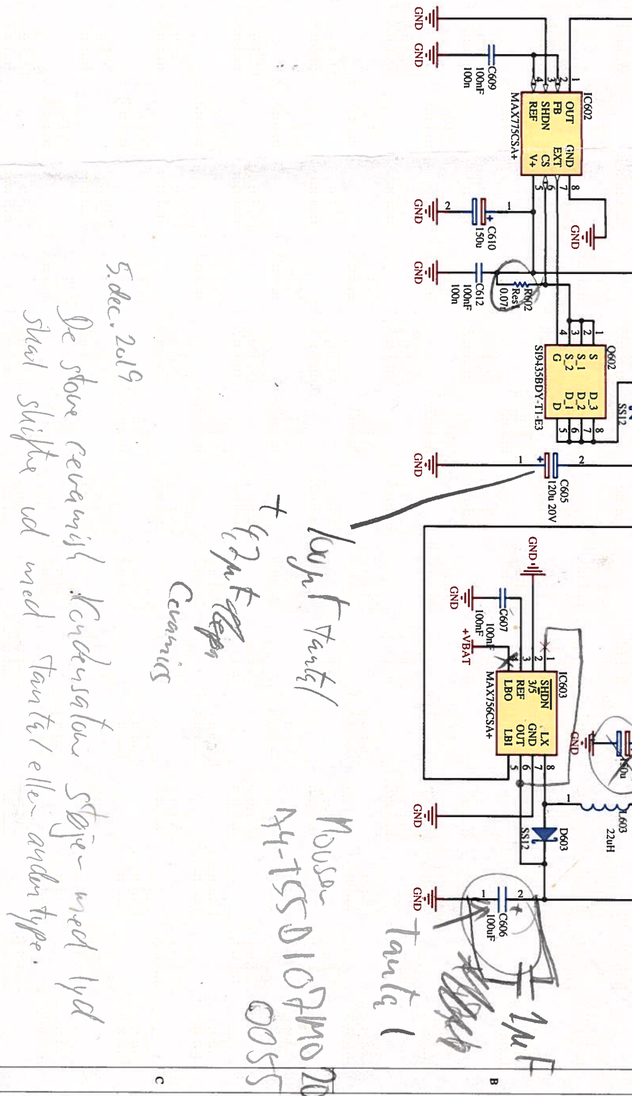
[picture p32: figure]
Ift; tLt_i cOS; L j tyci
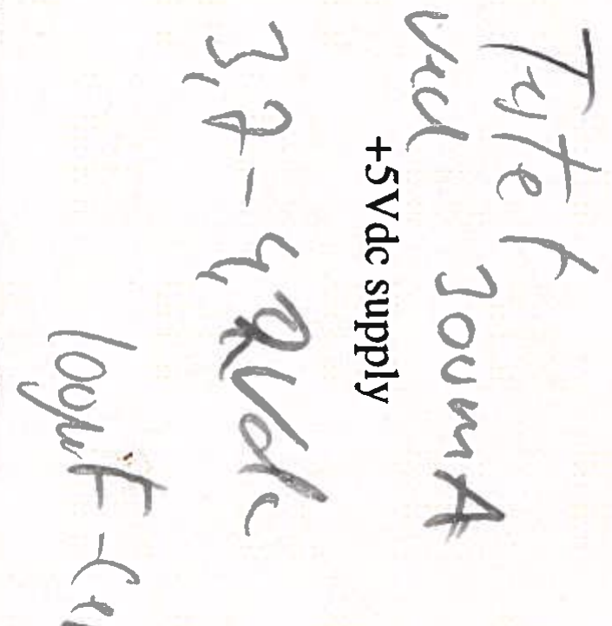
[picture p33: figure]

# ÉXbJÅTDER

# Size Number Revision

# A3 Power V1.O

# Date: 05-11-2019 j Sheet of 6-6

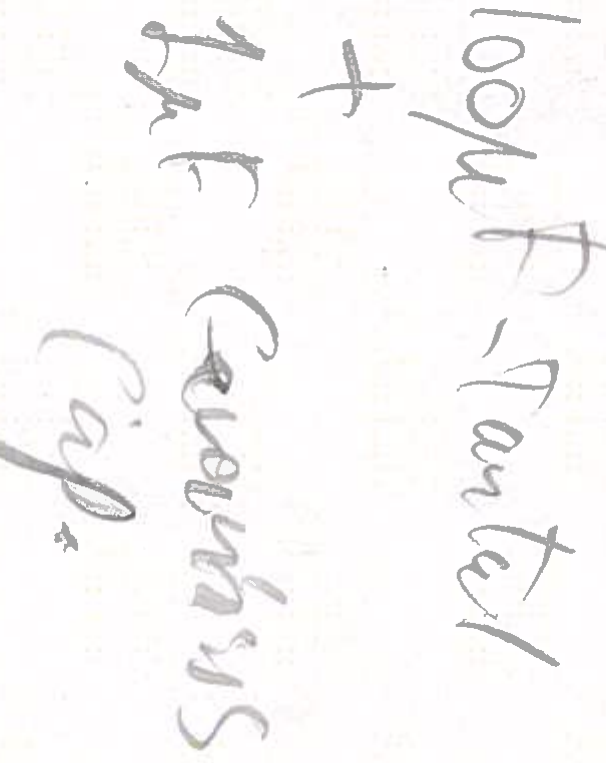
[picture p34: figure]
t1J Z,tijS

2 3 I 4 I 5

# +l2Vdc supply - (Bootstrapped)

6 I 7 I 8

# V( -l2Vdc supply - (Bootstrapped) +5Vdc supply

- I

A

## GND

)

I: 7

# File F:\Fran1&.\POWER.SchDoc I L3rawn By: Frank Hørzh Rasotussen

3 I 4 I 5 6 8 /

# i 2 3 I 4 I 5 I 6 7 8

(I

# ÷I2VDC

luF

(3

# -= j ItiF OND

# -I2VDC -IN A

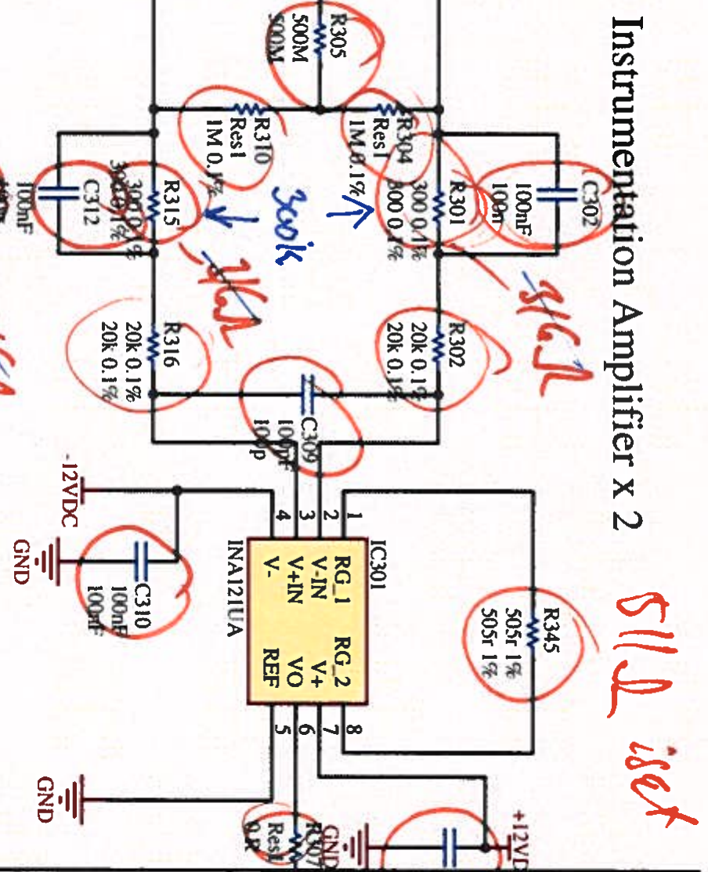
[picture p35: figure]
Instrume ion Amplifier x 2; IOOnF; R31ÖN fÅ ‘sIP; Rest ) “—1—- IMi; INAI2IUA; Res - I2VDC; OND

# High Pass Filter - 20Hz 2.th x 2

oo

OOnF

P30I

# OND 2-

# fleader 3

## OND

EN A

# ÷ I 2VDC

IuF

-)

# -EN B - I 2VDC

# 2f OND

3—,

# Header

II

3

# EN END

# SEMG

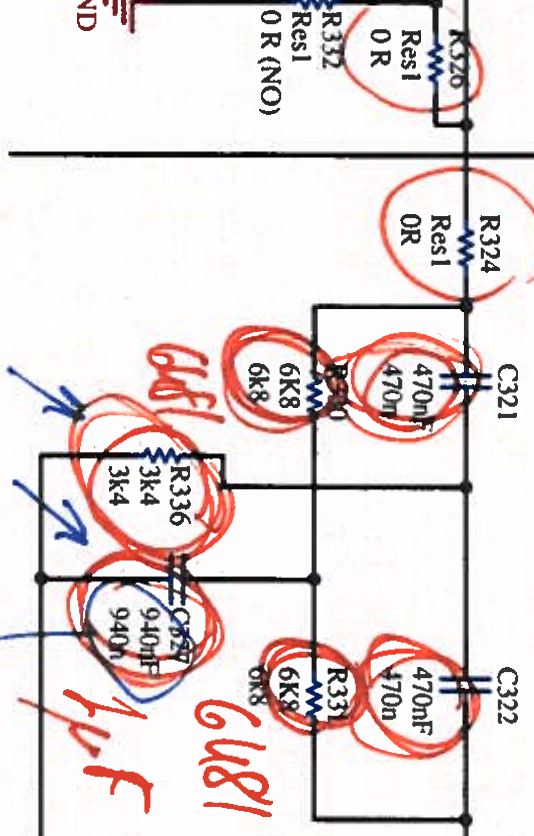
[picture p36: figure]
siN70 OR Rest; Rest
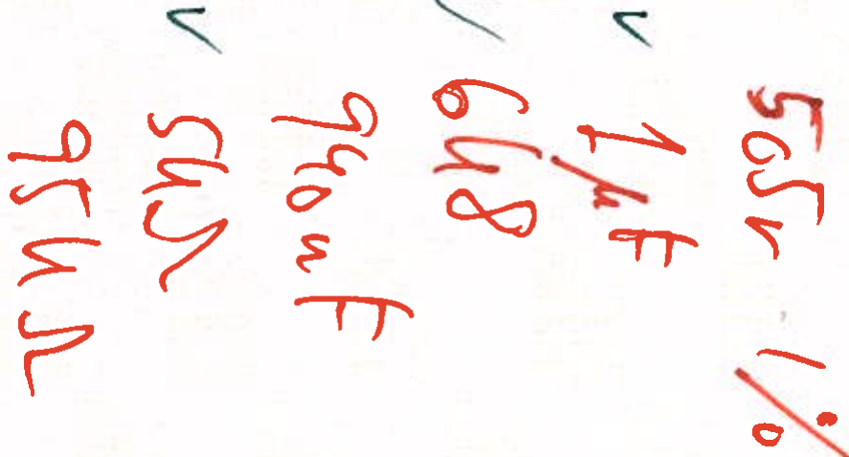
[picture p37: figure]

# Notch, 50Hz x 2

# Cov2c’ctt

# ADJ-Buffer x 2

487_

7k87

IuF

C30

7k87

# +I2VDCGtZID 2

13I’

## GND

ÆN

# 3000 9TEo.i — R322 .13 20k0I

—‘

## ResI

# L,r_1 i6 R327 VtWt. to

i)

C306

I(302

# OUTA OUTD INA- IND

# INA+ IND÷

# VDD VSS

# INB÷ INC÷

# INB- INC

# OUTB OUTC

# MAX44245ASD+

7

6

500N

## sdi

A

+12

—

505r17r

# [C303 ON]

# RO_I RG_2

# V-IN V+ 6 V±IN

;E’

# INAI2IUA

# -I2VD

C26

## OND

## OND

C305

SI47

10

# OJnF

nF

940t/ i

## lOOn

20k 0.1

20k0

4-
3:

# -If?\(J)

7K87
329

## OND

# _flr

## OND

‘1

# -I2VDC

IC303

# OUTA OUTD

# INA- IND

# INA÷ IND÷

# VDD VSS

# INB÷ INC+

# INB- INC

# OUTB OUTC

# MAX44245ASD+

zC3l
i,

I0

‘—10

## OND

8
10

# Low Pass filter- 500Hz - 4th. x 2

## OND

—

R.32

## OND

# (oot

C
B

4

r
A

D

2(4 (2

v

4

# Title Exo-Aider

# Size Number Revision

# A3 SEMG_1 Vl.0

# I Date: 05-i I-2019 Sheet at 3-6

# je: F:\Frank\EMO_l.SchDoc Drawn By: Frank Ho.h Rasmussen

# 7 / 2 I 3 5 6 i I

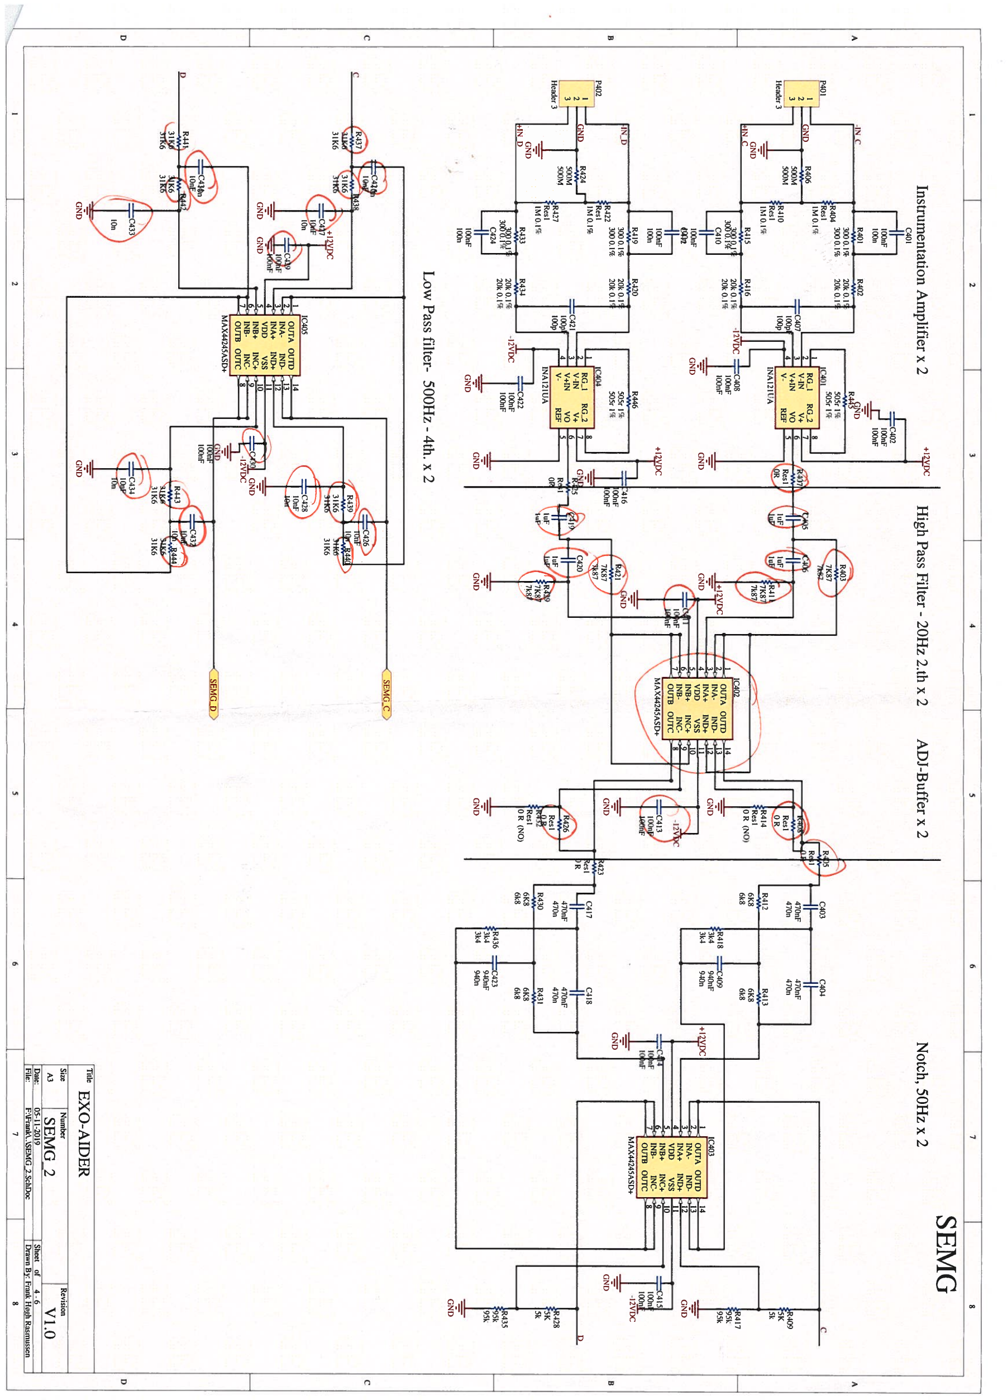
[picture p38: page 3]

# _P’J C

# Instrumentation Amplifier x 2

lOOn

# IOOnF

C40

# +IVpc

R40 I

20k
R-I02

0.1’

20k 0. I

——

# lOOnF

# IOOnF

## OND

R4-IS

# High Pass Filter -20Hz 2.th x 2

# I R404 3000.IÇr

i L___J

## ResI

# 2 OND R406

# 1M0.lq

# derEf

## OND

# IMO.I%

# R4 15 IN C

# ADJ-Buffer x 2

R4 16
f

505r 1Ç

1C401

505r 1%

# 4 RO_I RO_2

# _____

6

00

# V- REF 5 Resi

p

## ______________

## ROR

# INAI2IUA

# -I2VDC C408

## IIOOnF

# lOOnF

## OND

## OND

# Notch, 50Hz x 2

# SEMG

—-—w_

# 3000.1 20k0.IÇ) 3000.I’k 20k0I%

R4I9

## lOOn

# IOOnF

4fl’!

# IOOnF

C410

- —m

D

C403

‘,

# WHH

•f

470n

470nF

LR412

R420

470n

470nF
C404

# 3Q.IÇ’

R422 3000.12)
IM

## ResI

0. Vk

20k 0. 1
20k 0. I

P402

2

# eadefl

# i IR N0) \J / 1C402 114 i ._L ODTA OUTD — +I2VDC 2_j INA IND- 12 G\D NA IND+

_

745!

## OND

## OND

6k8
6K8

## OND

1N’ 0

R4 13

IOOp

loop

C421

6k8

6K8

## OOnF

## OOnF

416

c

Res

R427

I

# IM OI2

R433

R4 18
3k4
3k4

940n

940nF

C409

# +I2VDC

R446

f

# V+IN VO

# V- REF

0I
Re

# INA 12 IIJA

.L42.

# -I2VDC IOOnF

# [I00nF

## OND

## OND

5k
5K

R409

20k
R434

0.I’k

20k 0. 19)

Li

lOOn

# IOOnF

+ I
L

# 2VDC

4

# nF .JuF

OD

7k8

7K8

R4 17

95k
95k

1C403

# OUTA OIJTD

# INA- IND INA+ IND+

# VDD VSS

# INB+ INC+ INB- INC

# OUTB OUTC

# MAX44245ASD+

423

## OND

1I

nF
nF

J7F

# C418 esl I C417

IH

470n
470nF

R430

# Low Pass filter- 500Hz - 4th. x 2

## ResI

R426

OR

## ResI

(NO)

## OND

Tt -=.J_C415I

# -I2VDC

## OND

311<6

6k8
6K8

R43 I

6k8
61<8

3k4

3k4

R436

I)

940n

940nF

C423

5k

5K
R42S

31 K6

95k
95k

R435

## OND
