EXO-AIDER/exo-aider/AnalogFitlerSimulation/Version zero/README.txt

1) Open LT-Spice 
2) File -> Open... -> and open Analog_Filter_EMG.asc
______________________________________________________
______________________________________________________

For bode polt (AC analysis) 
1) Simulate -> Edit Simulation cmd -> AC analysis 
	- Type of sweep: Decade
	- Number of points per decade; 1000
	- Start frequency: 1
	- Stop frequency: 1000
2) Click run (running stick figure) 
3) Click on Output_bode on figure (buttom)

______________________________________________________
______________________________________________________
For transient 
1) Simulate -> Edit Simulation cmd -> Transient 
	- Stop time: 1 (or pick one)
	- Time to start saving data: 0 (or pick one)
2) Click run (runnint stick figure)
3) Click on Output_bode on figure (top)

______________________________________________________
______________________________________________________
Design tools can be found in "Filter links.txt"
