EXO-AIDER/exo-aider/PCB/Scaned documentation/Jan - sEMG and Filter Designs.pdf

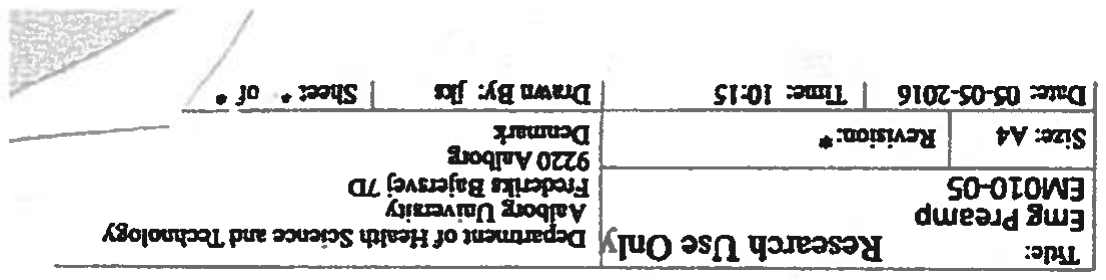
[picture p39: figure]
University Aalborg Preamp Emg; EMO1O-OS; 70 Bajersvej Erereriks; 922OAaiboty; Denmark A4_jRcviSion:* Size:; jl i- r-o5-2TTiiI

hnoTogy and Scizece Health of Dpant US esearch

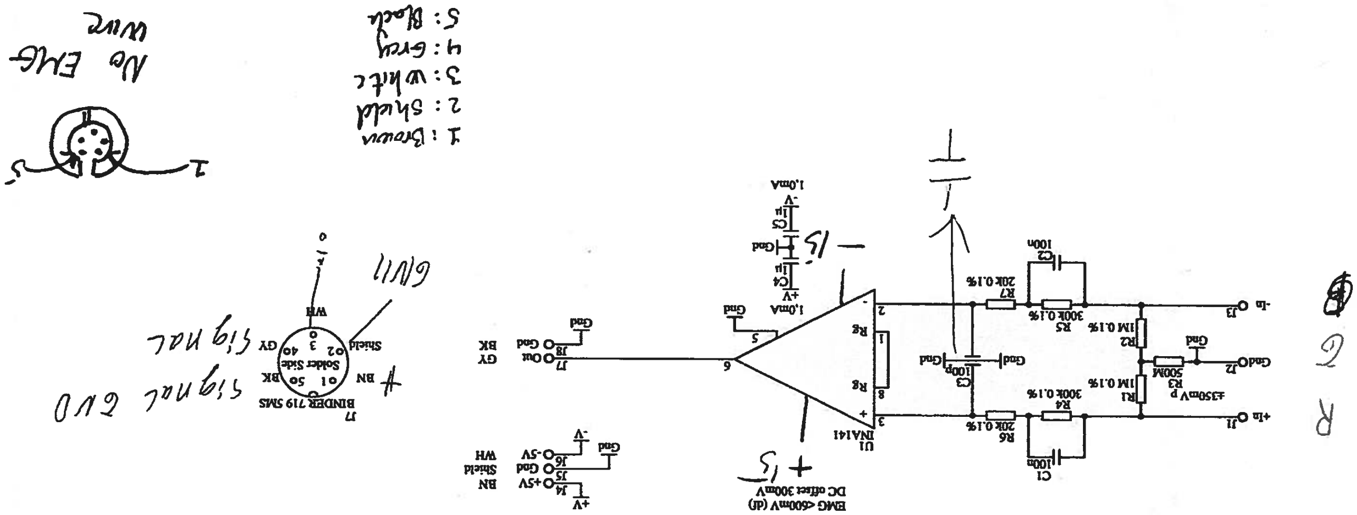
[picture p40: figure]
UIMO.1% R3; Gud; I’lRI ±35OmVp; ÇIIMO.t%; +V (dl) <600mV EMG; 300mV offset DC 114o+sv Ç —i-- Gud; Shield; 17 5MS 719 BINDER; 1BN/\BKSide Solder
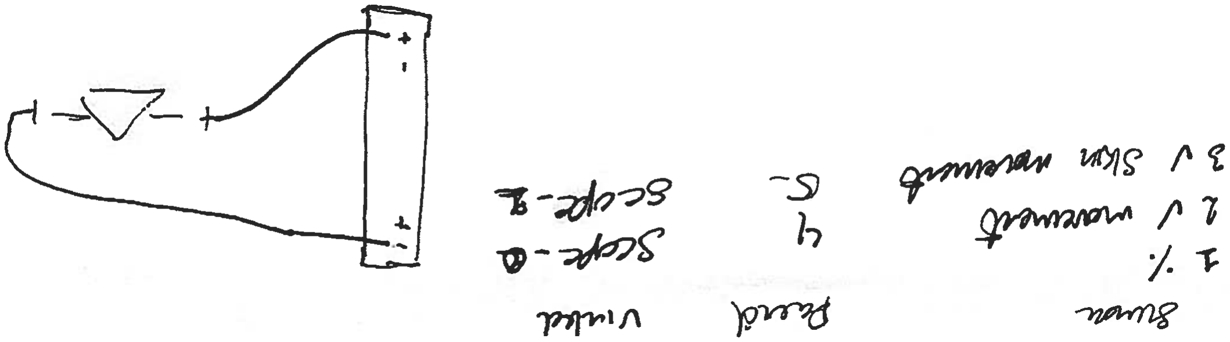
[picture p41: figure]
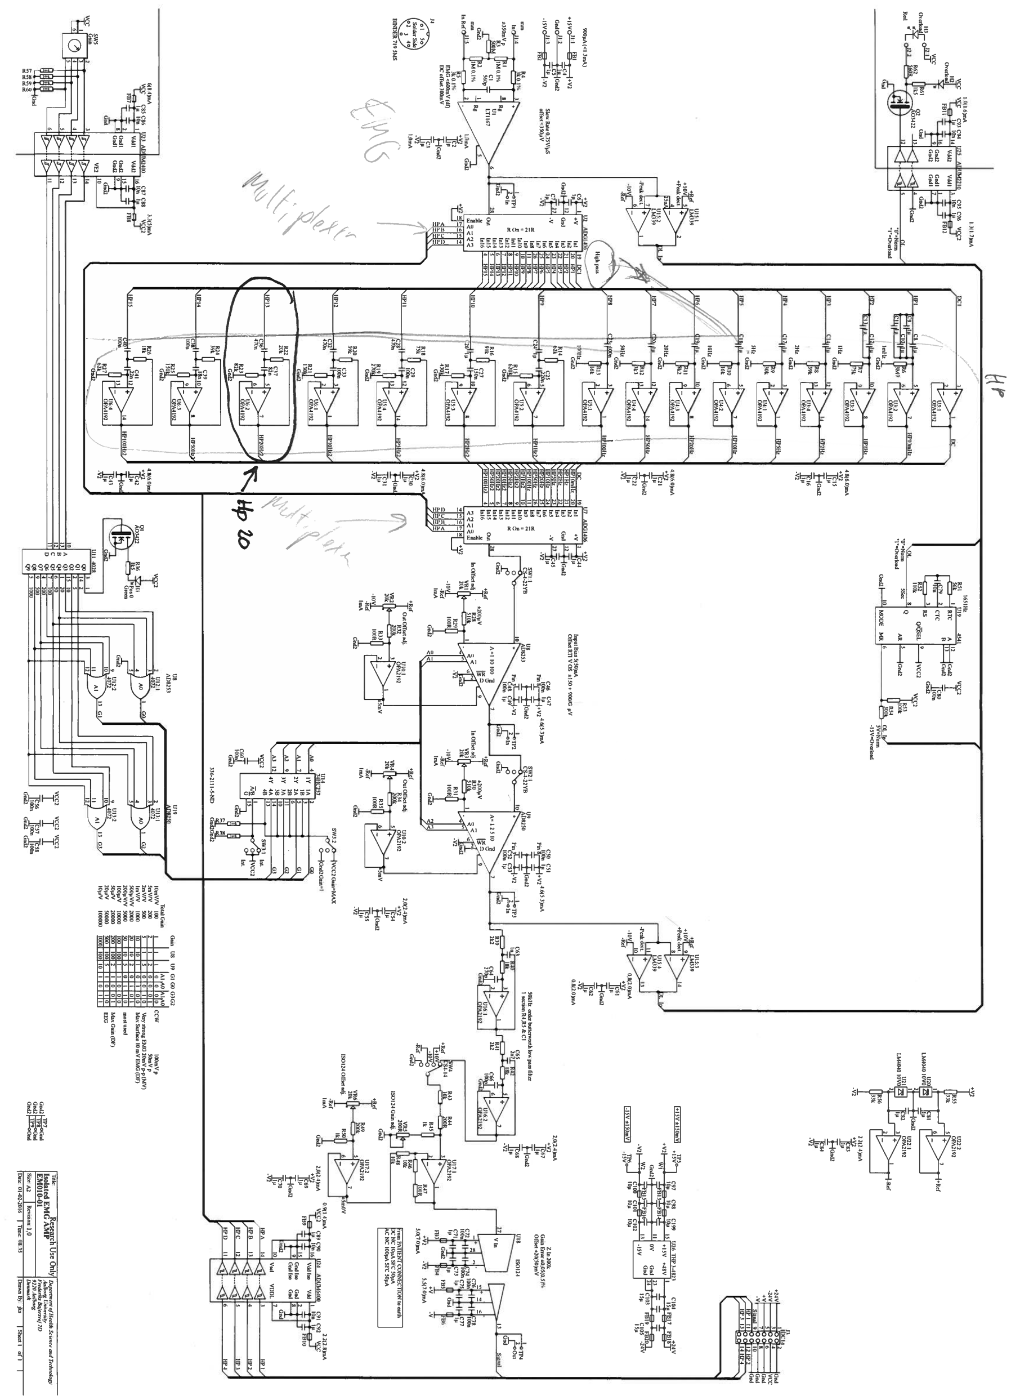
[picture p42: page 2]

<

“55

—
I

i:i

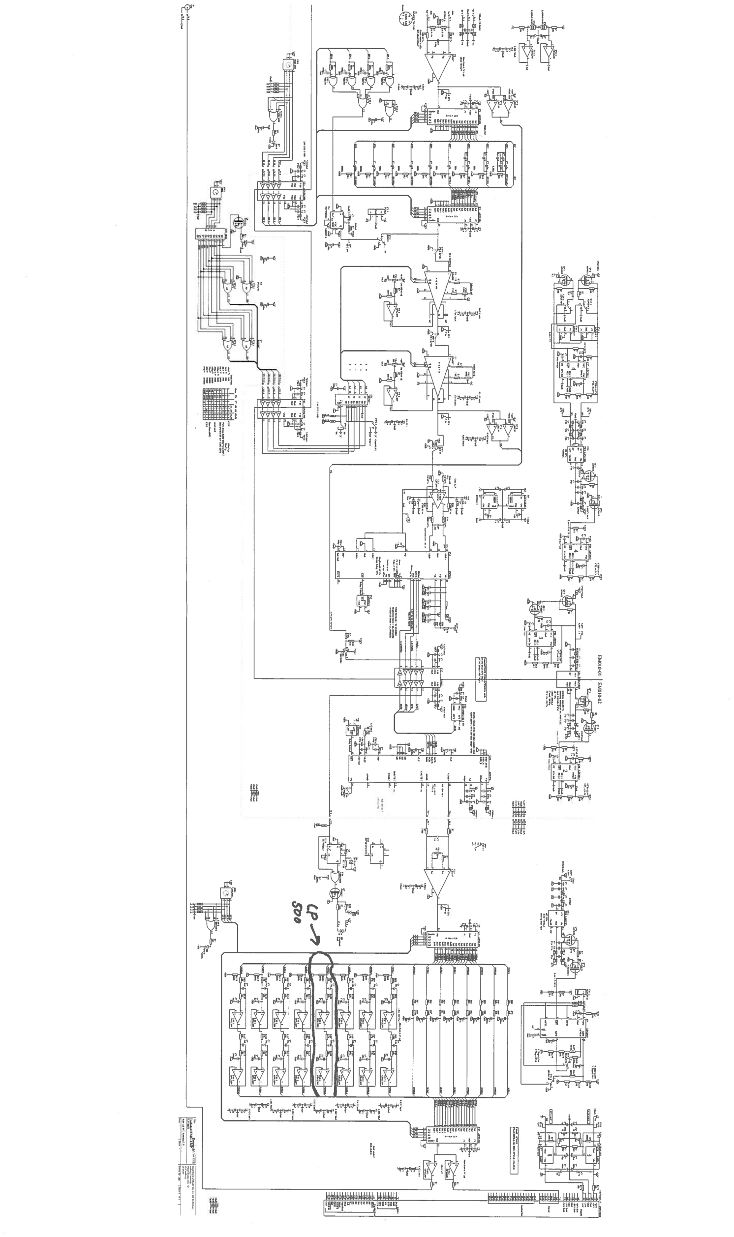
[picture p43: page 3]

EMOIO-Ol EMOIO-02

Ig

1;. __ s,ø__ ___ I ____
