EXO-AIDER/exo-aider/Documentation/armband_update/figures/two_modules.jpg

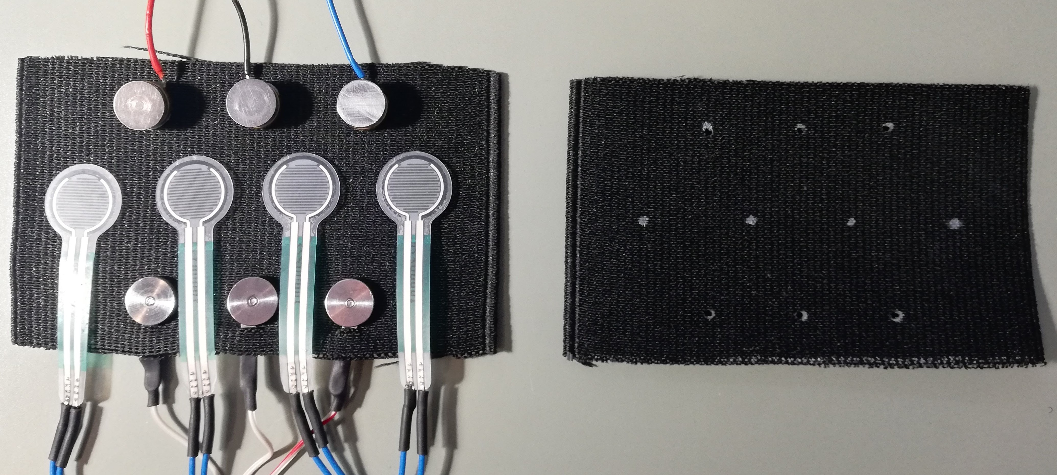
Documentation/armband_update/figures/two_modules.jpg
