EXO-AIDER/exo-aider/PCB/PCB1-Exoaider-3D.jpg

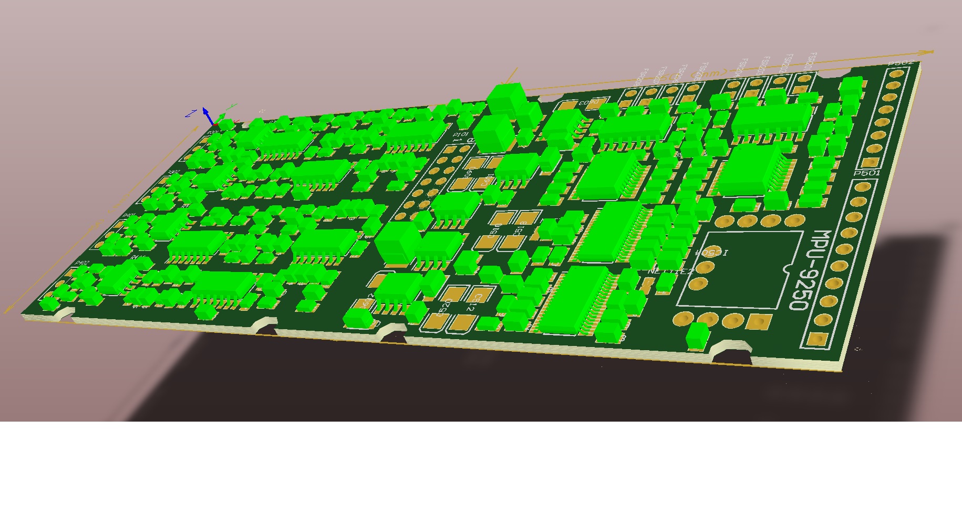
PCB/PCB1-Exoaider-3D.jpg
