EXO-AIDER/exo-aider/PCB/PCB1-Exoaider.jpg

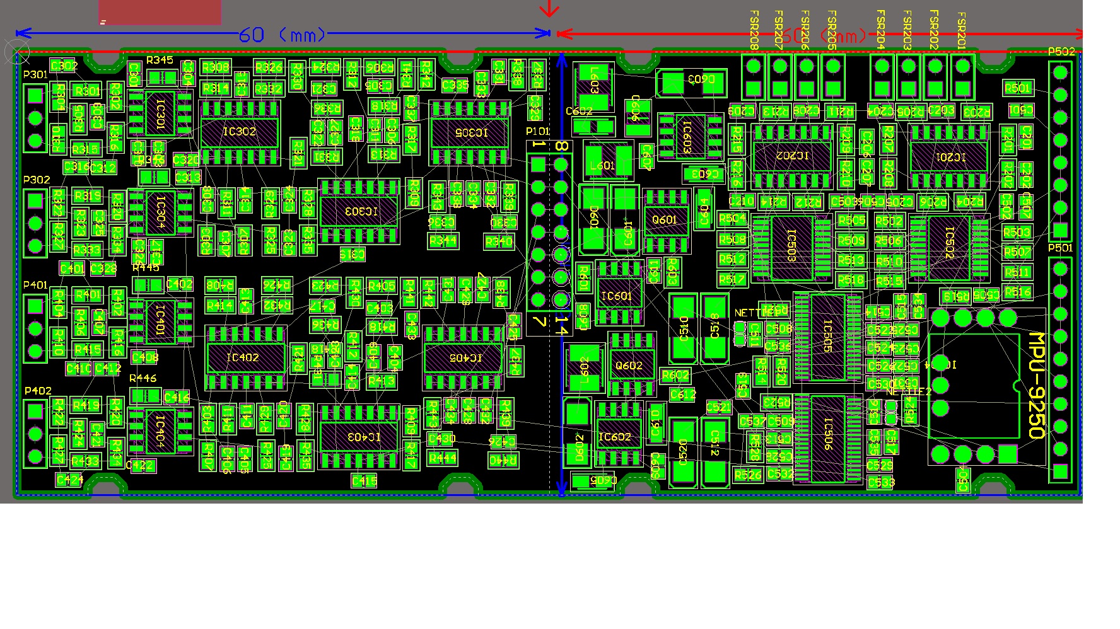
PCB/PCB1-Exoaider.jpg
