EXO-AIDER/exo-aider/PCB/PCB_3D.png

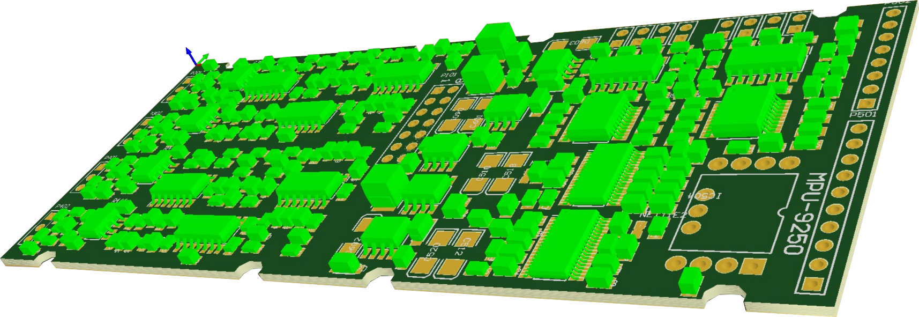
PCB/PCB_3D.png
