EXO-AIDER/exo-aider/PCB/PCB_D2.png

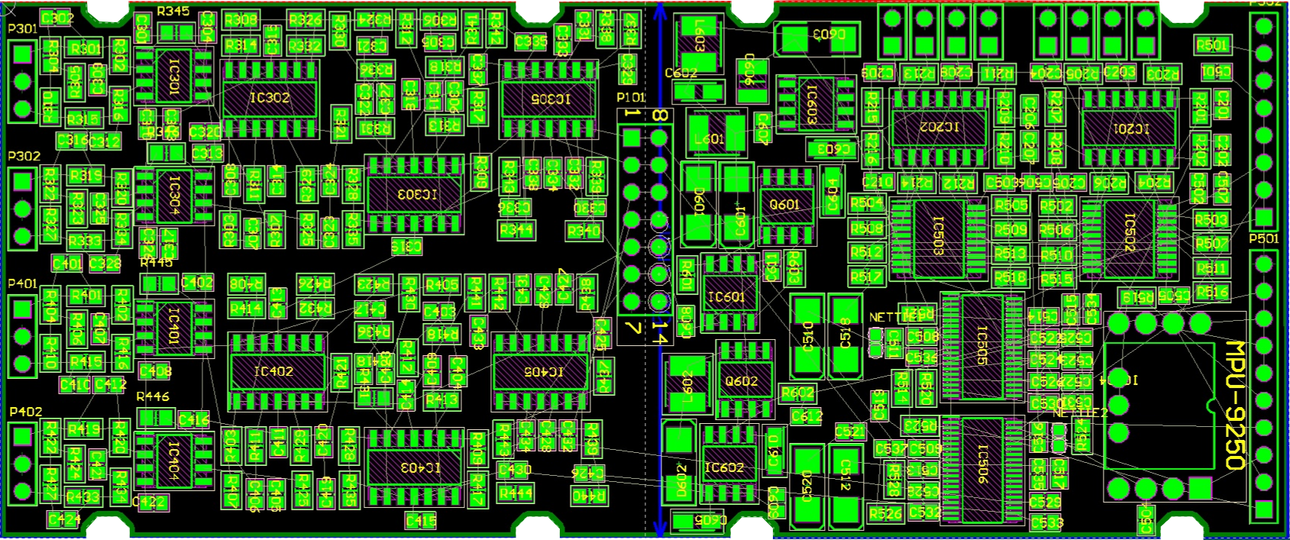
PCB/PCB_D2.png
