EXO-AIDER/exo-aider/esp32_new_bluetooth/Getting started.docx

# ESP32/MATLAB Communication Code

A getting started guide

# Overview

## List of core code files

ESP32 | MATLAB | Description
Message.h | Message.m | Implements a common high level message data class that keeps track of information before and after transmission.
SppBluetooth.h | SppBluetooth.m | Serial Bluetooth communication handler class. It takes care of message encoding, sending and receiving. Note that the ESP code checks for new data, while Matlab uses an event driven structure to reduce processing jitter.
TaskInterface.h | | Implements an ESP32 task interface. It dictates what functions and variables are required for a task class.
Main.cpp | | Takes care of all practical Bluetooth/scheduling/task call details.
board_type.h | | Interface for setting and receiving the board type (e.g, Motor Controller) from the eeprom memory.
Sheduler.h | | Implements a basic scheduler.

## List of example files

ESP32 Demo Files | Description
tasks/DemoTask.h | Minimum viable implementation of a task.
tasks/DemoMotorControllerTask.h | Implementation of a simulated motor controller.
tasks/ DemoSensorBandTask.h | Implementation of a simulated sensor band.

## High frequency signal sampling

Bluetooth typically have a polling rate of 125 Hz[^1] where it processes incoming or outgoing data. This makes it impossible to send and process signals at 1 kHz. To remedy this, these signals are aggregated and transmitted at a lower frequency, e.g., at 50 Hz. I recommended to send signals with a low frequency content at a low frequency to reduce the bandwidth requirement and ultimately reduce variation in network latency. For implementation purposes, the aggregated high frequency samples are transmitted every x samples. It looks like this:

Transmission Number | 1 | | | 2 | | | 3 | | | 4
High Frequency Samples | 1 | 2 | 3 | 4 | 5 | 6 | 7 | 8 | 9 | 10 | 11 | 12
Low Frequency Samples | 1 | 1 | 1 | 4 | 4 | 4 | 7 | 7 | 7 | 10 | 10 | 10

Table 1 – Example of sending the high frequency samples every 4th sample. Note that the low frequency samples remain constant throughout a transmission period.

The low frequency transmission rate is calculated by:

f_l (f_h , x)=(f_h)/x

## ESP32 Bluetooth name

Each ESP32 have a permanent and unique 12 hexadecimal MAC address that is incorporated into the Bluetooth network name. The mac address is pre-appended to “@Exo-Aider”. Some examples of network names

- 009ABBE350CC@Exo-Aider
- 60FB9912CFA4@Exo-Aider
- 74E80B12CFA4@Exo-Aider

## ESP32 Tasks

An ESP32 task class must inherit the TaskInterface class. It contains a few metadata variables that must be set during the initialization function.

Field | Type | Description | Example
description | String | | “Motor Controller”
high_frequency_sample_names | List of Strings | Names of the high frequency samples. | {“EMG1”, “EMG2”}
low_frequency_sample_names | List of Strings | Names of the low frequency samples. | {“torque”, “IMUx”, “FSR1”}

The ESP32 task metadata is extracted by MATLAB and used to keep track signals. For sample implementations, see:

- DemoTask.h
- DemoMotorControllerTask.h
- DemoSensorBandTask.h

To make a task available, it must be registered by the “get_potential_tasks” function in the “tasks/task_list.h” file.

## The Message class

A message contains the following information:

Field | Type | Description
Command | String | Let’s the receiver know what to do with the message.
Numbers | List of floating-point numbers | Number arguments.
Strings | List of strings | String arguments.

## Build in ESP32 commands

See main.cpp for the implementation of the different commands. An overview of the most useful arguments is provided here:

Command | Description/uses
ping | Used to check if the MATLAB-ESP32 connection is working.
set_board_task_name get_board_task_name | Sets/gets the board task name. This is the name of the active task. The board must be restarted for any changes to take effect.
restart | Restarts the board.
get_sheduler_periods_behind | Gets how many samples the scheduler is behind. Useful for debugging purposes.
set_sample_frequency get_sample_frequency | Sets/gets the high frequency sampling frequency.
set_send_signals_ratio get_send_signals_ratio | Sets/gets x from the High frequency signal sampling section.
set_send_signals get_send_signals | Sets/gets if the high and low frequency signals are being transmitted from the ESP32 to Matlab.
get_lf_signal_names | Gets a list of the low frequency sample names.
get_hf_signal_names | Gets a list of the high frequency sample names.
get_task_description | Gets the task description.
relay | Relays back whatever is send to the ESP32. Useful for determining if the communication protocol works.

# Common Use Cases

## Getting ESP32 configuration information

On boot the ESP32 transmits its metadata through the serial port. Sample information

Initializing...

* Board task name: "demo_motor_controller"

* Bluetooth name: "009ABBE350CC@Exo-Aider"

* 4 potential tasks: ["demo_left_sensor_band", "demo_motor_controller",
"demo_right_sensor_band", "demo_task"]

* 23 low frequency signals: ["n", "t", "u", "y", "r", "s3", "s4", "s5", "s6",
"s7", "s8", "s9", "s10", "s11", "s12", "s13", "s14", "s15", "s16", "s17",
"s18", "s19", "s20"]

* 0 high frequency signals: []

Initialized!

## Adding a new ESP32 task (Motor Controller, Sensor Band, etc.)

1. Create a new class instance that inherent the TaskInterface class. See the demo files in “tasks/Demo*.h” for information.
2. Add an instance of the class to the get_potential_tasks function in the “tasks/task_list.h” file.

## Connecting to the ESP32 from MATLAB

To connect to an ESP32 bluetooth connection from Matlab the following command is used:

SppBluetooth(bluetooth_name, board_task_name, buffer_size)
Where

bluetooth_name is the unique name of the ESP32 Bluetooth unit, e.g., 009ABBE350CC@Exo-Aider. This is the Bluetooth name printed during boot as depicted above.

board_task_name is the task name that the ESP32 unit should execute, e.g., demo_motor_controller. See available tasks during the unit startup.

buffer_size is the buffer sizes. The SppBluetooth class maintains consistent performance by using ring buffers for storing both messages and signals. With a sampling frequency of 1 kHz (f_s =1 kHz) and a desired buffer duration of 20 minutes (d=1,200 s) , the buffer size should have f_s ⋅d=1,200,000 elements. This uses around 10 MB per signal. The earliest signals in the buffer are automatically overwritten when the buffer overflows.

Example:

motor_controller = SppBluetooth(

'009ABBE350CC@Exo-Aider','demo_motor_controller', 1200 * 1000);

motor_controller.is_connected % Returns true if connected.

## Controlling the ESP32 from MATLAB

The behavior of the ESP32 can be controlled from MATLAB by sending commands or querying.

B.send(command, numbers, strings)

msg = B.query(command, numbers, strings)
Where

B is a SppBluetooth object.

command is a command character string, e.g., ‘ping’ or ‘send_signals’.

numbers is a vector of numbers, e.g., [1, 2, 123] or [] or [true].

strings is a cell array of character strings or a character string, e.g., {‘a’, ‘b’, ‘c’, ‘abc’} or {} or ‘a’.

msg is the answer to the query from the ESP32. It is empty if it timed out.

Example:

B.send('u', 10); % set the input for simulated exoskeleton of the ‘demo_motor_controller’ task.

msg = B.query('set_send_signals', true); % send signals to MATLAB

assert(msg.numbers(1) == true); % first argument is true of success

## Getting ESP32 signals from MATLAB

Stored signals can be retrieved using the get_signals function. The available ESP32 signals are printed during boot, e.g., from a previous example: ["n", "t", "u", "y", "r", ... ]. Note that “n” and “t” are non-optional variables, where “n” is the sample number and t is the local ESP32 time for a given sample. To get “u” samples,

signal_values = B.get_signals(signal_idx, sample_idx)
Where

signal_values are the signal values.

signal_idx specifies which signals to get, e.g., ‘n’ for a single signal and {‘n’, ‘u’, ‘r’} for multiple. The signal names corresponds with the names used for the high and low frequency signals specified in the task during task initialization.

sample_idx specifies the sample indexes as normal. As end is not available as function arguments, Samples less than 1, <1 , are relative to end, e.g., [-10:0] are is interpreted as [end-10:end]. If B.get_signals(signal_idx) are called, then it is the equivalent of using “:”.

Example:

B.sample_frequency = 1000; % Set sampling frequency.

B.send_signals_ratio = 20; % 1000 Hz / 20 = 500 Hz sendings frequency.

B.send_signals = true; % Enable sending.

pause(1); % Wait a bit for the samples to come in.

signal_values1 = B.get_signals({'t', 'u'}, -9:0); % Get the last 10 stored samples of t and u.

signal_values2 = B.get_signals({'t', 'u'}, 10:20); % Get the sample 10 to 20 of t and u.

signal_values3 = B.get_signal({'t', 'u'}); % Get all stored samples of t and u.

## List of important MATLAB commands for ESP32-MATLAB communication

Let B denote a connected SppBluetooth object.

Property/function | Description/Behavior
b = B.send_signals B.send_signals = b | Gets/sets the ESP32 send_signal variable.
msg = B.ping() | Pings the ESP32. Msg.numbers contains local time of the ESP32.
B.send_signals_ratio = n n = B.send_signals_ratio | Gets/sets the ESP32 send_signals_ratio variable.
b = B.is_connected | Checks if the connection is still alive.
B.get_signals | Get stored signals.

## Emulated exoskeleton control system

A small test is performed to get a feeling for the real-time performance of a simulated closed loop exoskeleton control system depicted on Figure 1. To create a realistic data processing load on Matlab, two sensor armbands are simultaneous transmitting their data to Matlab for processing. Figure 2 depicts the units used for the test setup. The devices used for the test includes:

Unit | Description/function
Matlab | Controller and Bluetooth master.
Motor Controller (ESP32 #1) | Board name: “demo_motor_controller”. Simulates a first order transfer function.
Left Sensor Band (ESP32 #2) | Board name: “demo_left_sensor_band”.
Right Sensor Band (ESP32 #3) | Board name: “right_sensor_band”. Same function as the Left Sensor Band above.

For an example see the SppBluetooth_test.m.

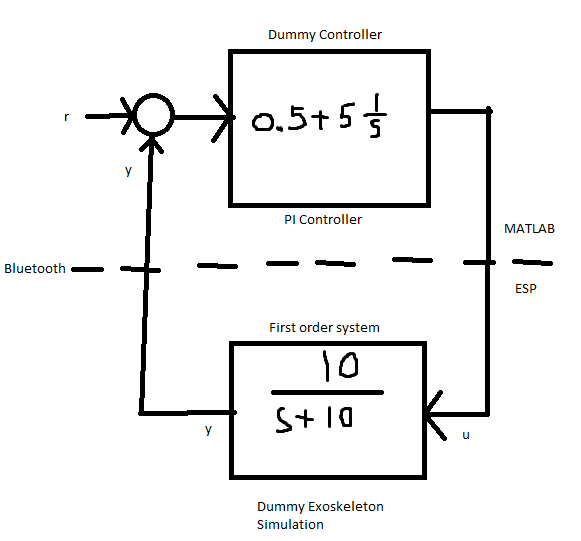
[picture p49: figure]
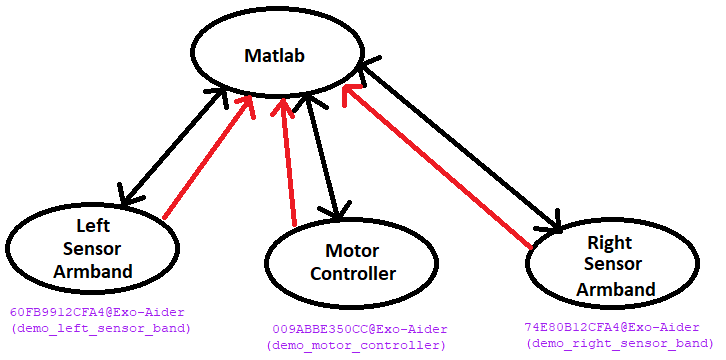
[picture p50: figure]

Figure 1 - Closed loop simulation of exoskeleton | Figure 2 - Test setup configuration. Black arrows indicate normal communication, while red arrows indicate periodic sending of signals when its local "send_signals" variable is true.

[^1] I’ve got this number from Bluetooth mouse specifications, but it corresponds nicely with my own findings.
