EXO-AIDER/exo-aider/Analog HW Test - lab/Stand alone sEMG/Common mode cabel length test/Setup.jpg

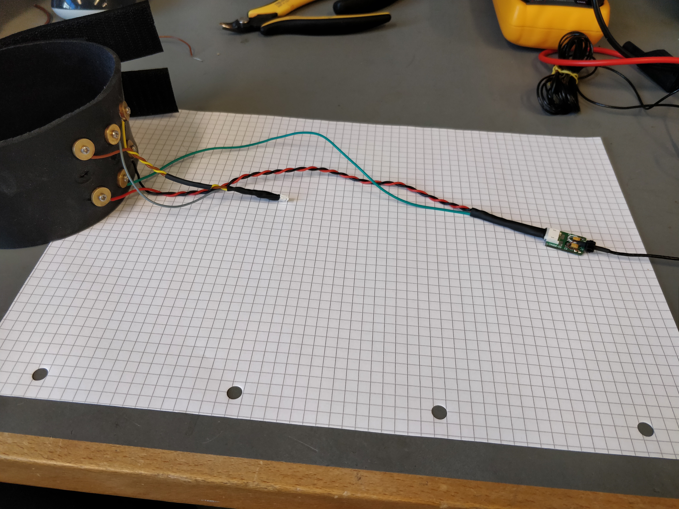
Analog HW Test - lab/Stand alone sEMG/Common mode cabel length test/Setup.jpg
