EXO-AIDER/exo-aider/Analog HW Test - lab/Stand alone sEMG/sEMG test (Bicep)/Setup.jpg

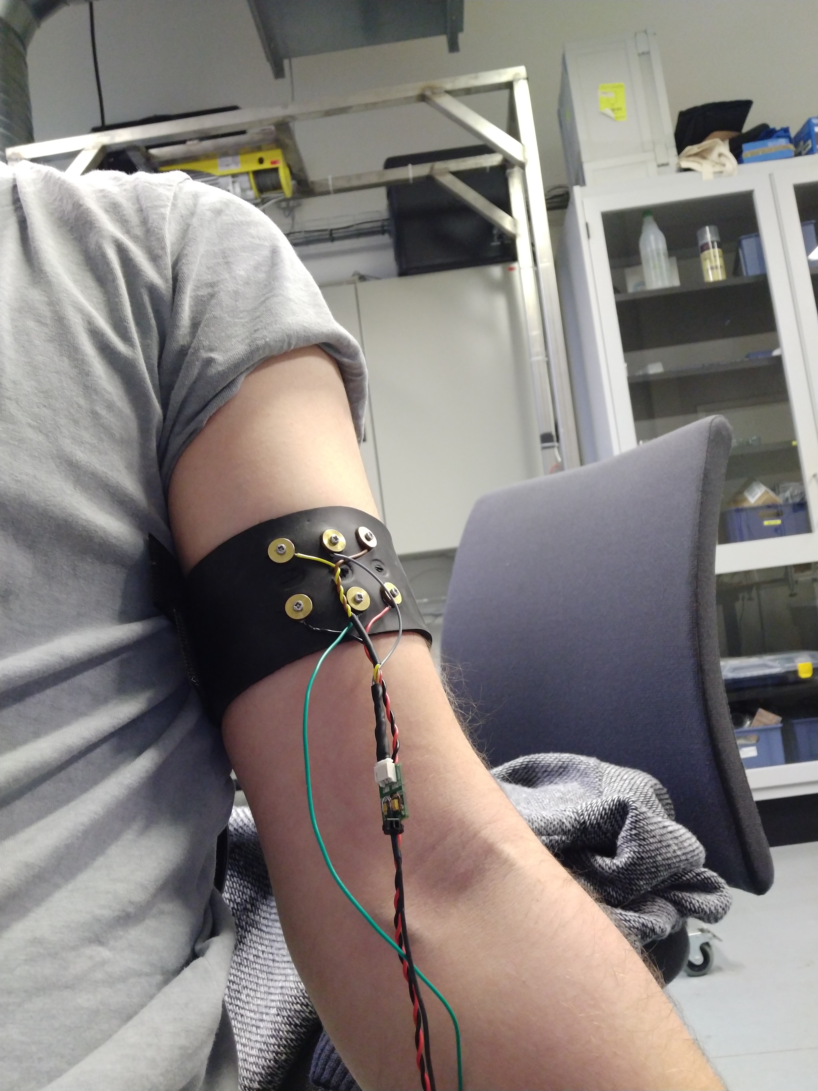
Analog HW Test - lab/Stand alone sEMG/sEMG test (Bicep)/Setup.jpg
