EXO-AIDER/exo-aider/Analog HW Test - lab/Stand alone sEMG/ReadME.txt

The stand alone sEMG is the sEMG design delivered by Jan Stavnshøj. 
These tests are made with the dry eletrodes (stainless steel / brass).
