EXO-AIDER/exo-aider/Analog HW Test - lab/Stand alone sEMG/Common mode cabel length test/Long.csv

x-axis | 1
second | Volt
-1.00937206258 | 0.0120603
-1.00927206258 | 0.0128643
-1.00917206258 | 0.0104523
-1.00907206258 | 0.0112563
-1.00897206258 | 0.0112563
-1.00887206258 | 0.0128643
-1.00877206258 | 0.0120603
-1.00867206258 | 0.0144724
-1.00857206258 | 0.0120603
-1.00847206258 | 0.0128643
-1.00837206258 | 0.0112563
-1.00827206258 | 0.0128643
-1.00817206258 | 0.0120603
-1.00807206258 | 0.0112563
-1.00797206258 | 0.0136683
-1.00787206258 | 0.0128643
-1.00777206258 | 0.0128643
-1.00767206258 | 0.0144724
-1.00757206258 | 0.0160804
-1.00747206258 | 0.0136683
-1.00737206258 | 0.0184925
-1.00727206258 | 0.0209045
-1.00717206258 | 0.0192965
-1.00707206258 | 0.0201005
-1.00697206258 | 0.0201005
-1.00687206258 | 0.0217085
-1.00677206258 | 0.0201005
-1.00667206258 | 0.0201005
-1.00657206258 | 0.0209045
-1.00647206258 | 0.0184925
-1.00637206258 | 0.0168844
-1.00627206258 | 0.0192965
-1.00617206258 | 0.0168844
-1.00607206258 | 0.0152764
-1.00597206258 | 0.0160804
-1.00587206258 | 0.0160804
-1.00577206258 | 0.0144724
-1.00567206258 | 0.0152764
-1.00557206258 | 0.0160804
-1.00547206258 | 0.0160804
-1.00537206258 | 0.0160804
-1.00527206258 | 0.0168844
-1.00517206258 | 0.0176884
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
