EXO-AIDER/exo-aider/Analog HW Test - lab/Stand alone sEMG/Common mode cabel length test/Short.csv

x-axis | 1
second | Volt
-1.00937206258 | 0.00361809
-1.00927206258 | 0.00353769
-1.00917206258 | 0.00289447
-1.00907206258 | 0.00305528
-1.00897206258 | 0.00337688
-1.00887206258 | 0.00305528
-1.00877206258 | 0.00257286
-1.00867206258 | 0.00225126
-1.00857206258 | 0.00225126
-1.00847206258 | 0.00257286
-1.00837206258 | 0.00249246
-1.00827206258 | 0.00273367
-1.00817206258 | 0.00313568
-1.00807206258 | 0.00369849
-1.00797206258 | 0.0041005
-1.00787206258 | 0.00297487
-1.00777206258 | 0.00281407
-1.00767206258 | 0.00257286
-1.00757206258 | 0.00305528
-1.00747206258 | 0.00241206
-1.00737206258 | 0.00249246
-1.00727206258 | 0.00225126
-1.00717206258 | 0.00217085
-1.00707206258 | 0.00257286
-1.00697206258 | 0.00249246
-1.00687206258 | 0.00217085
-1.00677206258 | 0.00257286
-1.00667206258 | 0.00297487
-1.00657206258 | 0.00265327
-1.00647206258 | 0.00225126
-1.00637206258 | 0.00249246
-1.00627206258 | 0.00265327
-1.00617206258 | 0.00152764
-1.00607206258 | 0.00257286
-1.00597206258 | 0.00281407
-1.00587206258 | 0.000723618
-1.00577206258 | 0.00104523
-1.00567206258 | 0.00112563
-1.00557206258 | 0.00144724
-1.00547206258 | 0.000643216
-1.00537206258 | 0.000723618
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
