EXO-AIDER/exo-aider/Analog HW Test - lab/Stand alone sEMG/Flexion/8 kg.csv

x-axis | 1
second | Volt
-2.47656006383 | 0.0100503
-2.47606006383 | 0.0120603
-2.47556006383 | 0.00603015
-2.47506006383 | 0.00603015
-2.47456006383 | 0.0080402
-2.47406006383 | 0.00201005
-2.47356006383 | 0.0100503
-2.47306006383 | 0.0080402
-2.47256006383 | 0.00603015
-2.47206006383 | 0.00201005
-2.47156006383 | 0.0040201
-2.47106006383 | 0
-2.47056006383 | 0.0040201
-2.47006006383 | -0.00603015
-2.46956006383 | 0.00201005
-2.46906006383 | 0
-2.46856006383 | 0
-2.46806006383 | -0.00603015
-2.46756006383 | 0.00201005
-2.46706006383 | -0.00201005
-2.46656006383 | 0.0040201
-2.46606006383 | 0.00201005
-2.46556006383 | 0
-2.46506006383 | 0.0120603
-2.46456006383 | 0
-2.46406006383 | 0.0120603
-2.46356006383 | 0.0040201
-2.46306006383 | 0.0080402
-2.46256006383 | 0.00603015
-2.46206006383 | 0.00603015
-2.46156006383 | 0.00201005
-2.46106006383 | 0.00201005
-2.46056006383 | -0.00201005
-2.46006006383 | -0.0080402
-2.45956006383 | -0.00603015
-2.45906006383 | -0.0100503
-2.45856006383 | -0.0120603
-2.45806006383 | -0.0080402
-2.45756006383 | -0.00603015
-2.45706006383 | -0.00201005
-2.45656006383 | -0.0120603
-2.45606006383 | -0.00603015
-2.45556006383 | -0.00603015
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
