EXO-AIDER/exo-aider/Analog HW Test - lab/Stand alone sEMG/Electrode heatup time/Impedance 3.csv

x-axis | 1
second | Volt
-2.500000000000e+001 | 2.01005e-003
-2.499440000000e+001 | -1.80905e-002
-2.498880000000e+001 | -6.03015e-003
-2.498320000000e+001 | 1.40704e-002
-2.497760000000e+001 | 2.01005e-003
-2.497200000000e+001 | -1.80905e-002
-2.496640000000e+001 | 8.04020e-003
-2.496080000000e+001 | 1.60804e-002
-2.495520000000e+001 | -1.80905e-002
-2.494960000000e+001 | -1.20603e-002
-2.494400000000e+001 | 2.21106e-002
-2.493840000000e+001 | 1.80905e-002
-2.493280000000e+001 | -2.21106e-002
-2.492720000000e+001 | -6.03015e-003
-2.492160000000e+001 | 1.80905e-002
-2.491600000000e+001 | -1.20603e-002
-2.491040000000e+001 | -6.03015e-003
-2.490480000000e+001 | 1.40704e-002
-2.489920000000e+001 | 4.02010e-003
-2.489360000000e+001 | -2.81407e-002
-2.488800000000e+001 | -1.20603e-002
-2.488240000000e+001 | 1.00503e-002
-2.487680000000e+001 | 2.01005e-003
-2.487120000000e+001 | -4.02010e-003
-2.486560000000e+001 | 2.01005e-002
-2.486000000000e+001 | 4.02010e-003
-2.485440000000e+001 | -1.40704e-002
-2.484880000000e+001 | -6.03015e-003
-2.484320000000e+001 | 1.80905e-002
-2.483760000000e+001 | 8.04020e-003
-2.483200000000e+001 | -2.01005e-002
-2.482640000000e+001 | 4.02010e-003
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
