EXO-AIDER/exo-aider/AnalogFitlerSimulation/Version one/Analog_Filter_EMG.asc

1kHz: voltage; SINE(0 0.1 1000 0)
10Hz: voltage; SINE(0 0.1 10 0)
50Hz: voltage; SINE(0 0.1 50 0 0 0)
C1: cap; 470nF
C2: cap; 82nF
C3: cap; 27nF
C4: cap; 33nF
C5: cap; 12nF
C6: cap; 100nF
C10: cap; 470nF
C11: cap; 82nF
C14: cap; 12nF
C15: cap; 27nF
C16: cap; 33nF
C17: cap; 100nF
DC_offset: voltage; SINE(0.4 0.1 2 0)
R1: res; 82k
R2: res; 20k
R3: res; 10k
R4: res; 12k
R5: res; 15k
R6: res; 5k6
R11: res; 4
R12: res; 4
R13: res; 4
R14: res; 1
R15: res; 4
R16: res; 4
R17: res; 82k
R18: res; 20k
R21: res; 15k
R22: res; 5k6
R24: res; 10k
R25: res; 12k
Randome_noise1: bv; V=sin(2*pi*(1+0.5*time)*time)
Randome_noise: bv; V=(rand(time*1e18)-0.5)*0.2
Signal1: voltage; SINE(0 0.1 50)
Signal: voltage; SINE(0 0.1 200)
U1: UniversalOpamp2
U2: UniversalOpamp2
U3: UniversalOpamp2
U6: UniversalOpamp2
U8: UniversalOpamp2
U9: UniversalOpamp2
V2: voltage; 12
V3: voltage; -12
V4: voltage; 0; AC 1V 0
Named nets: 0, +12V, -12V, Signal_Noise, Output, 20_Hz_HP, 500_Hz_LP, Output_bode, Frequency_Swep, Pure_Signal, EMG
.ac dec 1000 5 1000
;tran 0 5 0
