EXO-AIDER/exo-aider/AnalogFitlerSimulation/Version zero/Analog_Filter_EMG.asc

1kHz: voltage; SINE(0 0.1 1000 0)
3k4: res; 6k8
10Hz: voltage; SINE(0 0.1 10 0)
50Hz: voltage; SINE(0 0.1 50 0 0 0)
C1: cap; 1µF
C2: cap; 1µF
C3: cap; 940nF
C4: cap; 470nF
C5: cap; 470nF
C6: cap; 0.01µF
C7: cap; 0.01µF
C8: cap; 0.01µF
C9: cap; 0.01µF
C10: cap; 1µF
C11: cap; 1µF
C12: cap; 940nF
C13: cap; 470nF
C14: cap; 470nF
C15: cap; 0.01µF
C16: cap; 0.01µF
C17: cap; 0.01µF
C18: cap; 0.01µF
DC_offset: voltage; SINE(0.4 0.1 2 0)
R1: res; 7k87
R2: res; 7.87k
R3: res; 31k6
R4: res; 6k8
R5: res; 3k4
R6: res; 5k
R7: res; 95k
R8: res; 31k6
R9: res; 31k6
R10: res; 31k6
R11: res; 4
R12: res; 4
R13: res; 4
R14: res; 1
R15: res; 4
R16: res; 4
R17: res; 7k87
R18: res; 7.87k
R19: res; 6k8
R20: res; 6k8
R21: res; 3k4
R22: res; 5k
R23: res; 95k
R24: res; 31k6
R25: res; 31k6
R26: res; 31k6
R27: res; 31k6
Randome_noise1: bv; V=sin(2*pi*(1+0.5*time)*time)
Randome_noise: bv; V=(rand(time*1e18)-0.5)*0.2
Signal1: voltage; SINE(0 0.1 50)
Signal: voltage; SINE(0 0.1 200)
U1: UniversalOpamp2
U2: UniversalOpamp2
U3: UniversalOpamp2
U4: UniversalOpamp2
U5: UniversalOpamp2
U6: UniversalOpamp2
U7: UniversalOpamp2
U8: UniversalOpamp2
U9: UniversalOpamp2
U10: UniversalOpamp2
V2: voltage; 12
V3: voltage; -12
V4: voltage; 0; AC 1V 0
Named nets: 0, +12V, -12V, Signal_Noise, 20_Hz_HP, 50_Hz_Notch, 500_Hz_LP, Output, Output_bode, Frequency_Swep, Pure_Signal
.tran 0 2 0
;ac dec 1000 1 2k
