EXO-AIDER/exo-aider/PCB/ESP32_shield/esp_shield/esp_shield.kicad_pcb

## KiCad design PCB/ESP32_shield/esp_shield/esp_shield.kicad_pcb (2020-07-28)

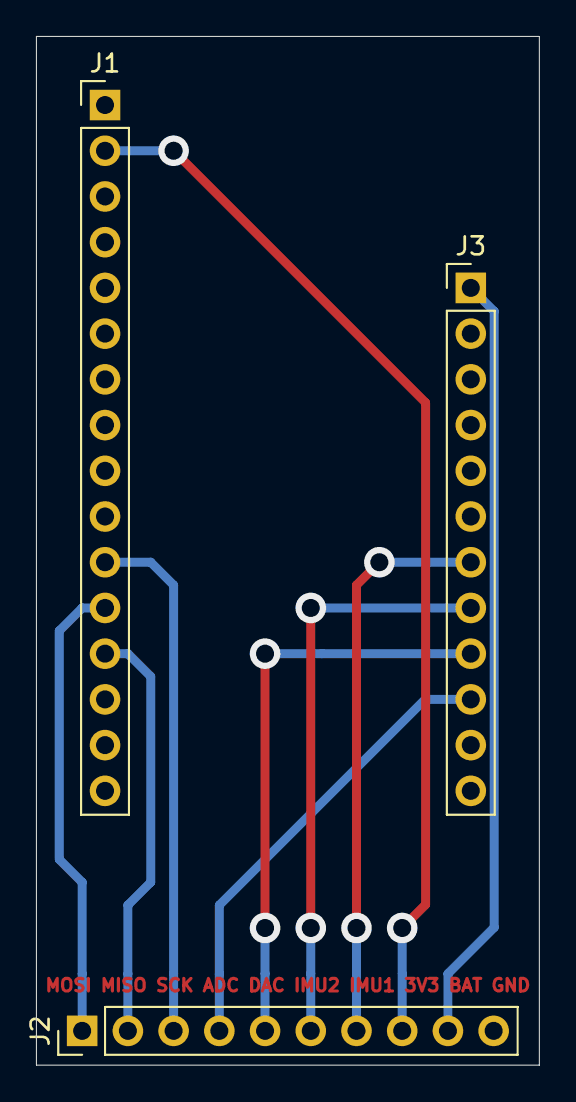
[picture p53: board esp_shield.kicad_pcb from above]

Board: 2 copper layers, 27.9 x 57.2 mm, 3 parts (0 on the bottom side), 10 nets.

Parts:
J1: Conn_01x16; PinHeader_1x16_P2.54mm_Vertical
J2: Conn_01x10; PinHeader_1x10_P2.54mm_Vertical
J3: Conn_01x12; PinHeader_1x12_P2.54mm_Vertical

Connections:
3.3V: J1.2, J2.8
BAT: J2.9, J3.1
CS_ADC: J2.4, J3.10
CS_DAC: J2.5, J3.9
CS_IMU1: J2.7, J3.7
CS_IMU2: J2.6, J3.8
GND: J1.4, J2.10
MISO: J1.13, J2.2
MOSI: J1.12, J2.1
SCK: J1.11, J2.3
