EXO-AIDER/exo-aider/(commit log)

2020-01-09 Added all files from Simon and the files i have made myself
    [0.csv, 1 kg.csv, 10.csv, 100.csv, 50.csv, 8 kg.csv, Impedance 1.csv, Impedance 2.csv]
2020-01-10 added matlab script for testing different notch filters
2020-01-13 50 Hz notch filter implemented in matlab. Pinout for sEMG board is made
2020-01-14 data from filter analysis including a wip matlab script for visualization
2020-01-20 Changed names in matlab matrix to fit FSR pins on PCB. Pins has to be moved on next PCB iteration. Added more datafiles from filter and diff amp measurements
2020-01-21 Sample frequency in main loop
2020-01-22 Sending and receiving gyro data
2020-01-23 included gyro data in "all" function and simplified timer
2020-01-30 Sped up SPI clock to get a more reliable sample frequency
2020-02-05 Trying to make FSR 5 and 6 work. Still not working
    [main.cpp]
2020-02-10 changed some clk freqs with great results. Everything is working
    two FSR sensors has an offset but is fixed by swapping resistors on DAC feedback
    [main.cpp]
2020-04-30 matlab for bluetooth. All sensors added
2020-07-20 Small changed, nothing special + schematics
2020-07-28 pcb for esp32 and minor software changes
    [esp_shield.kicad_pcb, esp_shield.sch]
